mhmmdbdrhmd/can-logger-esp32/CHANGELOG.md

# Changelog

## v2.0.3 — the retry added in v2.0.2 could send the wrong payload

**Use this instead of v2.0.2 if you use the Send tab.** The retry across CAN
passes that v2.0.2 introduced was wrong in two ways, both found in review of
that release and both reproduced on the host:

- **A retried Send rebuilt its frame, and a grouped or multiplexed command
  rebuilt into the wrong bytes.** Several values that share one frame are
  assembled in a holding buffer, and that buffer is consumed when the frame
  goes out. A retry built the frame a second time, found the held values gone,
  and transmitted the selector with a zeroed payload — a valid-looking command
  carrying wrong numbers to whatever acts on it. A retry now carries the frame
  that was already built and sends exactly those bytes.
- **A retried Send was reported as failed even when it went out.** The outcome
  was recorded before the decision to retry, so the dashboard — which keeps the
  first result it sees for a ticket — showed "the bus was too busy to get on"
  for a Send that succeeded a pass later. Nothing is recorded now until the
  result is final. This also stops one retried Send filling the four-deep
  result ring and evicting every other Send's outcome.
- A retry that cannot be put back (the request queue is full) is reported as a
  failure instead of disappearing silently.
- A cyclic repeat is marked "do not retry" with its own flag, so the failure
  line no longer claims a cyclic send was "retried on later passes too".
- `test/test_cantx.cpp` covers all of it, including a real grouped send built
  from `examples/machine.dbc`: with the fix removed, the test reports the held
  value going out as zero.

## v2.0.2 — a failed Send no longer costs frames, and a recovered SD write no longer breaks a row

- **A Send that loses arbitration no longer loses received frames.** On a busy
  bus a Send can lose arbitration on all three attempts. The receive buffers
  were emptied while a send was waiting, but not between attempts and not
  after the last one, and writing the error line took long enough for the
  controller to overflow. On the bench, 220 failed sends cost 69 frames in one
  10-minute recording. The buffers are now emptied after every attempt and
  after the logging that follows a send. The same bench, with 117 failed sends
  in 10 minutes, recorded `lost 0`. `test_mcp2515.cpp` checks the drains.
- **A recovered SD write no longer duplicates bytes.** When a write fails, the
  card may already hold the start of the block. The recovery added in v2.0.1
  wrote the whole block again, and on the bench 29 bytes appeared twice and
  broke one row. The recovery now reads the file's length on the card and
  continues from there. Bytes the card dropped before the block are counted as
  lost. `SD_FAULT_TEST_AT_KB` now lets part of the block reach the card before
  the failure, which is how it happened. `test_sdutil.cpp` covers the
  arithmetic.
- **`lost` comes first on the status line.** The line is cut at
  `LOG_LINE_CHARS`, and with `lost` at the end, `lost 69` was printed as
  `lost 6`. It now follows the time: `REC 1.csv 00:02:21 | lost 0 | ...`.
- **The heap figures in the `health:` line reach the card.** The line had
  outgrown `LOG_LINE_CHARS` and was cut at `minHeap=`, so `block`, `lowBlock`
  and `allocFail` never appeared in a recording. It is now three lines
  (`health:`, `health sd:`, `health heap:`). The first also carries `gap` and
  `tx`, the longest time between two drains and the longest pass spent sending,
  which were measured but never printed.
- **The closing summary reports the smallest free block in bytes,** against the
  2308 bytes an inbound connection needs, with the count of refused
  allocations. "1 KB" hid the difference between a dashboard that answers and
  one that refuses to connect.
- **`/api/log` sends at most 16 lines a reply,** from one buffer taken once.
  With the Log tab open it could build the whole 80-line ring, about 14 KB,
  and copy it into a second String of the same size. The page polls every
  700 ms, so it still gets more than 20 lines a second.
- The host test that checks a handler emits no field twice now sees field
  names with an underscore.
- **A Send that loses arbitration is retried on a later pass of the CAN task**
  (`TX_RETRY_PASSES`, 3), after the receive buffers have been drained and long
  enough for a burst to end. The attempts inside `sendFrame()` are back to
  back, so on a bursty bus they are all spent inside the same burst. Measured
  twice at 5 sends/s into a bursty 350 frames/s bus: 9 and 602 failed sends
  without it, 0 and 0 with it, no frames lost either way. Six attempts back to
  back scored 1 and 1 and were not taken - on a bus that acknowledges nothing,
  six attempts block the receive path for 120 ms.

## v2.0.1 — nothing the layout uses is trimmed, and a failed SD write is recovered

- **Trimming keeps what the dashboard and the Send tab use.** The Web UI sheet
  can now trim both frame maps together when neither alone is enough, and it
  lists each trade-off it found - both maps at the current name length, or one
  map with shorter names - with how many signals each map keeps. A message
  that a dashboard cell or a sendable value names is never dropped, and is
  kept whole. The page saves any layout change still waiting before it trims,
  previews or exports. When the messages the layout uses are too much on their
  own, the sheet says so. `test/test_desk.py` pins the largest messages in a
  layout and checks that nothing it uses is lost.
- **A failed SD write no longer stops the recording in silence.** FatFS keeps
  an error on an open file once a write fails and refuses every later write to
  it. On a bench board, one card error four and a half minutes into a
  recording left the CSV frozen for the rest of it, while the `.log` beside it
  carried on and the status line said `lost 0`. The CSV is now reopened for
  appending and the write retried. Anything that still cannot be written is
  counted: `SD LOST n KB` on the status line, on the page's SD card, in
  `/api/status` as `sdLost`, and in a closing line that calls the file
  incomplete. `SD_FAULT_TEST_AT_KB` injects the failure for a bench test.
- The core no longer prints "does not exist" errors when the firmware removes
  or checks for a file that is not there.

## v2.0.0 — two buses

The logger now records **two CAN buses at once**, on one clock, into one file.
This is a fork of `can-logger-esp32` and keeps its history; everything below is
what changed to get the second bus, and what it cost.

Major version because **the CSV schema changed** — see below. Recordings made by
the single-bus logger are still readable by the desk tools, but a file written
by this one has an extra column.

### One desk tool, one setup file, and a name length chosen per setup

- **`customize.py` is the one desk tool.** It takes one or two frame maps, or an
  exported bundle. The page gains **Preview**, which shows the setup the way the
  logger will load it: names at the chosen length, a map cut down if the logger
  cannot hold it whole, cells that would no longer resolve left out.
- **The Web UI badge predicts from the maps** (`tools/heap_model.py`) whether
  the logger will keep serving the page while it records, for name lengths 64,
  32 and 16, and offers the fixes as buttons: trim `frames.dbc`,
  `frames2.dbc` or both, or a shorter name length. A trim never drops a
  message that a dashboard cell or a sendable value uses, and the page sends
  any layout change still waiting to be saved before it trims.
- **Export writes one file, `logger.bundle`**: both maps, the layout and the
  name length (`tools/make_bundle.py`). Names too long for the length are
  **abbreviated**, not cut (`tools/dbc_abbrev.py`: `EngineCoolantTemperature`
  -> `EngineCoolTemp`), kept distinct, and the layout is rewritten to match.
  The logger unpacks it at start-up, once, and renames it `/logger.applied`;
  **Import** on the logger's own page uploads one and restarts.
- **The name length is chosen at run time.** Names live in one pool sized from
  the bundle's `name_max`, so a setup at 32 or 16 gives its memory back to the
  web server without a rebuild. `DBC_NAME_MAX` is now only the ceiling.
- **The web server got 12 KB back** by default: `FRAME_QUEUE_LEN` 256,
  `LOG_QUEUE_LEN` 16, `TASK_STACK_WRITER` 6144. On a bench board with one small
  map the largest free block at start-up went from 34804 to 47092 bytes, and the
  page from dying within a minute to answering every request. The `.log` file
  reports each task's unused stack.
- **A recording no longer drops frames while it opens its files.** Finding a
  free file name on a well-used card took 1.5 s and filled the queue; the queue
  is now drained in between, and those frames are counted but not recorded.
- **The boot log records the heap at every step of starting a recording**, and
  each frame map's per-entry cost.

### Found on a real bench: the dashboard died in station mode, and a Send cost frames

Running this firmware on a real machine - station mode through a router, a
WROOM board with no PSRAM, and a large vendor frame map - turned up faults that
the hotspot setup had hidden. Before the fixes, with a small map and nothing
else changed, the dashboard stopped answering 25 seconds after boot and never
came back (`write(): fail on fd 50, errno: 11` once a second on the console),
while the recording ran on untouched.

**The web server**

- **The page went out in parts of up to 73 KB per socket write.** lwIP's send
  buffer is a few kilobytes; in station mode the write came back EAGAIN and the
  page died half-sent. It now goes out in 2 KB slices with a real
  Content-Length, pre-compressed (`src/webpage_gz.h`, 3.3x smaller, generated by
  `tools/gen_page_gz.py` and checked by `run_tests.sh`).
- **Nothing stopped a stalled send.** A client that stopped reading held the
  one-client-at-a-time server for up to ten seconds per slice. Every response
  now gives up after `WEB_SEND_MAX_MS`, a single write is bounded with
  `SO_SNDTIMEO`, and an abandoned page is closed with a reset instead of being
  retransmitted for minutes out of the heap new connections need.
- **`/api/status` and `/api/dash` rebuilt their reply with a reallocation per
  append**, five times a second - and then reserved 16 KB in one piece for a
  2 KB reply, which failed once the heap was fragmented. Static buffers, sized
  to what the replies measure.
- **Unknown `/api/` paths and `/favicon.ico` were answered with the whole
  page.** Now a small 404 and a 204.
- **`/api/signals` streamed a large map back to back without yielding**, so
  the reply was truncated and the page never finished starting. It yields
  between chunks now.

**Memory**

- **The heap gauge read the wrong pool.** `ESP.getFreeHeap()` counts 32-bit
  IRAM that `malloc()` can never return, so it reported ~41 KB that did not
  exist. `src/mem.cpp` reads the 8-bit pool, tracks the largest free block and
  its low-water mark, logs a boot ladder into the recording, and traps failed
  allocations - which is how the real mechanism was found: every refused
  allocation was the ~2.3 KB receive buffer an incoming connection needs.
- **`DBC_HEAP_RESERVE` had been tuned against that wrong gauge.** Against the
  real figure it exceeded the whole heap and every message on both buses was
  dropped. It is 40 KB now, and a zero budget is reported as a configuration
  error rather than as a map that did not fit.
- **The radio now starts before the frame maps load.** It needs a few large
  contiguous blocks, and a freshly parsed map had already cut the heap into
  pieces: one vendor map left 80 KB free and Wi-Fi still would not start.
- **`FRAME_QUEUE_LEN` is 512, not 2048** (now 256, see above). The queue comes
  out of the heap; its measured peak on a 350 frames/s bus was 13.
- The boot log now says, at the end of setup, whether the dashboard can be
  expected to stay reachable - see "Keeping the dashboard reachable" in the
  README for the three zones it reports and where they come from.

**Frames**

- **A transmit stopped the receive path.** `sendFrame()` waits up to 20 ms per
  attempt for the controller, in the only task that empties the receive
  buffers; at 350 frames/s that is enough to overflow. The wait now drains both
  controllers between polls. With it, a 10-minute recording at 350 frames/s
  with one Send every second lost no frame; a run without it has not been
  made, so how often the old wait cost frames is not measured.
- **The receive task wrote to the SD card.** The overflow and sticky-flag paths
  called `LOG_FILE` from the task with the microsecond deadline, onto the card
  the CSV was being written to. They are counted now, and reported on the status
  line; nothing in that task touches the card.

**Frame maps**

- **The DBC was read one byte at a time**: one filesystem call per byte, which
  made a megabyte-class map take over a minute and a half at boot. 512-byte
  blocks now.
- **Ceilings raised** to 4096 messages / 16384 signals / 16384 value labels,
  and `DBC_NAME_MAX` to 64 (now the ceiling, see above): a real vendor map lost 310 names at 32, and two
  signals differing only past character 31 became one CSV column.
- **A readable map that did not fit was reported as thousands of unparsable
  lines.** Skipped definitions are counted apart from malformed ones now, and
  the `NS_` keyword list no longer counts as an error in every file.
- **Signals of a dropped message were attached to the previous one.** When the
  message table was full, the `SG_` lines under the message that did not fit
  were appended to the last message that did - which then decoded its frames
  with another message's bits. They are skipped now, and a test fails if they
  are not.
- **A `VAL_` line naming a clipped signal in full never matched**, so its value
  table was lost. Names are compared the way they were stored.
- **The SD card could stay wedged after a USB flash.** A reset mid-write leaves
  the card holding its data line busy; the firmware now clocks it free before
  mounting and retries the whole speed ladder with longer pauses.

**Desk tools and tests**

- **`preview_dashboard.py` merged value tables across messages** that reuse a
  signal name (normal in J1939): wrong labels, and a heap estimate 2.3x the
  firmware's. Keyed by message and signal now; the parser comparison in
  `run_tests.sh` counts value labels and includes a file that exercises it.
- `run_tests.sh` runs from any directory; the page-versus-firmware field check
  accepts underscored names; the host shims answer heap questions with figures
  measured on a board instead of a flat 200 000.

### The schema: eight columns, `bus` second

```
t_us;bus;id;name;signal;value;unit;raw
0;1;0x100;NodeStatus;Uptime;42;s;
1500;2;0x100;PumpState;Pressure;3.5;bar;
```

Those two rows carry **the same identifier on different buses, decoded into
different messages**. That is the normal case on a real machine, and it is the
reason the column exists.

`bus` is second, not appended, because it is part of a row's *identity* rather
than its payload: with two buses an identifier alone no longer names anything.
Group on `(t_us, bus, id)`. Putting it next to `t_us` and `id` is what makes
that hard to forget.

The companion `N.meta` now carries `"schema": 2`, so a tool can branch on a
number instead of counting separators. `tools/parse_log.py` and
`tools/plot_log.py` read both schemas and report a seven-column recording as
`CAN1`.

### Each bus can find its own bit rate

`CAN1_AUTODETECT` / `CAN2_AUTODETECT`, off by default. Set one to `1` and that
bus listens at each `(bit rate, crystal)` pair the driver has timings for and
keeps the first that decodes real frames. The pair already in `config.h` is
tried first, so a correct configuration costs one 300 ms window and usually far
less.

It listens in **listen-only mode whatever `CAN<n>_LISTEN_ONLY` says**. At the
wrong bit rate a normal-mode node reads valid traffic as malformed and answers
with error frames; a tool that corrupts the bus while it works out how to read
it would be worse than no tool.

Two honest limits, both in the log and in the README:

- **It needs traffic.** A quiet bus is indistinguishable from a wrong bit rate.
  Detection then fails and the `config.h` values are used — it never leaves a
  bus unconfigured.
- **A crystal and a bit rate multiply.** The registers for 250 kbit/s on an
  8 MHz module produce 500 kbit/s on a 16 MHz one, and both decode the same wire
  perfectly. Nothing over SPI separates them, so the configured crystal is swept
  first and a fallback to the other one is warned about: the bus is readable
  either way, but the reported *rate* is scaled by the same factor.

The Bus tab says which it was — `250 kbit/s detected` versus
`250 kbit/s assumed` — because a rate the machine confirmed and a rate somebody
typed are worth different amounts of trust. `MCP_RATES` / `MCP_CRYSTALS` are
exported from the driver and asserted against its own timing table in
`test/test_mcp2515.cpp`, so a candidate the search tries can never be one the
driver would quietly refuse.

### One frame map per bus

`/frames.dbc` for CAN1, `/frames2.dbc` for CAN2. Separate files, because the
same identifier routinely means different things on two buses — a shared map
would decode CAN2 with CAN1's meanings and be confidently, silently wrong. Two
buses that genuinely share an ID space can be given identical files.

Either may be absent; that bus records raw bytes, exactly as a logger with no
map at all does. They are fitted to the heap in order, CAN1 first, so a very
large map on CAN1 is the one that shrinks CAN2's — and the log says so when it
happens.

### One task drives both controllers

Both MCP2515s share VSPI; only CS and INT are unique. The obvious design — a
reader task each — is the wrong one: two tasks would contend for the SPI bus
mutex on the one path that has a hard deadline, adding a priority-inversion
surface in exchange for nothing, since the work is identical either way.

So there is still one reader task at priority 20. It drains controller 1, then
controller 2, on every pass. Two ISRs, one per INT line, each pushing into its
own timestamp ring and notifying that same task.

Both rings are fed from the same `esp_timer`, which is the point: a frame on
CAN1 and a frame on CAN2 are directly comparable to the microsecond. Two
recorders with two clocks cannot do that, and it is the whole reason to log two
buses on one device.

### One block SPI transfer per transaction, instead of one per byte

This is the change the second bus actually turned on, and it would have been
invisible with one.

A controller holds two frames; at 500 kbit/s a third arrives about **200 µs**
after the first. `readFrame()` already used the right instructions — `READ
STATUS` then the burst `READ RX BUFFER`, 16 bytes, ~13 µs of clock at 10 MHz —
but it clocked them with one `SPIClass::transfer(uint8_t)` per byte, and on
arduino-esp32 each of those is a complete peripheral round trip costing 2–3 µs.

| | per frame | drain 2 controllers × 2 frames | vs 200 µs |
|---|---|---|---|
| per-byte | ~45 µs | ~245 µs | **misses** |
| block | ~18 µs | ~115 µs | ~40 % margin |

Every register access and both frame paths now go through `MCP2515::xfer`, one
`transferBytes()` per transaction. `MCP2515::readRegs()` was dead code and is
gone.

### The margin is measured

`drainMaxUs` — the worst microseconds one pass spent emptying **both**
controllers — is on the dashboard, in `/api/status` and in the `health:` line.
Under 120 µs is comfortable; approaching 200 µs means the margin is gone. A
figure you can read beats a design note you have to trust.

### `CanFrame` gained a bus and did not grow

The struct was exactly 24 bytes with no padding left, so a plain `uint8_t bus`
would have aligned it to 32 — a third more RAM for a queue thousands of entries
deep. Packing the flags as bitfields (`ext:1, rtr:1, tx:1, bus:1`) got it for
free and changed no call site, since those only ever held 0 or 1. A
`static_assert` now makes adding a field a compile error rather than a silent
30 % increase.

### Sizing, for the doubled frame rate

| | was | now | why |
|---|---|---|---|
| `FRAME_QUEUE_LEN` | 1024 | **2048** | Its old comment claimed "one second of slack". At ~6 250 frames/s those entries are 164 ms — less than the ~320 ms outliers SD cards produce. 2048 is ~330 ms, just past the worst stall. |
| `SD_BLOCK_BYTES` | 8192 | **32768** | SD cards are far more efficient with large writes, and two busy buses can ask for several hundred KB/s. |

Static RAM went from 24.9 % to 33.2 %. Nearly all of that is the queue.

### Per-bus health, everywhere

`RecStatus` split into `BusHealth` (frames, interrupts, overflows, load, frame
map, listen-only) and the shared remainder (one queue, one card, one writer).
Split rather than suffixed, because the interesting failure is asymmetric — one
bus deaf while the other is fine — and a routine that averaged the two would be
incapable of saying so.

The status line, the `health:` lines, `/api/status` and the dashboard all report
per bus. The *Data Integrity* card keeps the floor-vs-exact distinction and now
breaks the floor down by bus.

### The web app is dual-aware throughout

- **Health strip**: one card per controller — frame rate, interrupt rate, load,
  INT level — plus a *Capture Path* card showing `drainMaxUs` against its
  deadline. SD and Data Integrity stay shared, so which numbers are per bus is
  obvious at a glance.
- **Bus tab**: a controller selector; live signals and the identifier table show
  one bus at a time. Both buses' values keep feeding the dashboard regardless of
  which is on screen.
- **Dashboard**: a cell remembers its bus, is badged when it is not CAN 1, and
  resolves against that bus's map. The cell editor has a bus picker above the
  signal list — changing it clears the signal, because a reference from the
  other map would produce a cell that looks configured and never updates.
- **Frame map upload**: two header buttons, `Frame map: CAN 1` and
  `Frame map: CAN 2`, so the target is readable *before* the click rather than
  explained in the toast afterwards — and reachable without first working out
  which bus some other tab happens to be showing.
- **Send**: setpoints carry a bus, frames are grouped by bus as well as message,
  and the one-off frame box has its own selector.

`dash.cfg` gained `bus=` on `cell` and `send` lines. It is written only when it
is not bus 1, so every existing layout round trips to exactly the file it came
from.

### One role per bus, and a header column for each

`Role` said which `BU_` node of the frame map this logger IS — the fact that
separates a reading from a command, and the thing both **Fill** buttons split
on. There was one of them, for two buses. It could not be read: the button said
`Role: Tester` without saying which bus that was about, and its sheet listed
whichever map the cell editor happened to be pointed at.

Now one per bus. The header carries a **column per controller** — that bus's
frame map above, that bus's role below — because both are facts about one bus
and nothing else, and a column with the bus named over it says so in less width
than four buttons each spelling it out:

```
        CAN 1          CAN 2
     [Frame map]    [Frame map]
     [Role: Host]   [Role: none]
```

Two buses have separate frame maps and therefore separate `BU_` node lists, so a
name identifying this logger on one usually does not appear in the other's file.
More importantly the logger is routinely **a node on one bus and a listener on
the other** — driving a diagnostic bus while only watching the powertrain — and
one shared answer forced those two situations to give the same reply.

`dash.cfg` gains a `bus=` token on `role`, with bus 1 implicit, so every
`role "Tester"` line ever written still means exactly what it meant:

```
role "Tester"
role "Logger" bus=2
```

`dashDropUnresolved()` now holds each role to **that bus's** node list. It used
to accept a name either map knew, on the reasoning that a tester is still a
tester when the other bus has never heard of it — with a role per bus that
reasoning inverts: a name CAN1's file knows nothing about cannot be the node
this logger is on CAN1, and keeping it leaves CAN1's Fill split on a node absent
from CAN1.

Two things this turned up while it was being tested:

- **`Fill from bus` had silently stopped ordering by anything.** It read the
  live-signal list from a top-level `sig` in `/api/status` — which moved inside
  `can[]` when the second bus arrived. The lookup found nothing, so the button
  that exists to put the signals *actually arriving* first was placing them in
  plain file order and capping nothing. It reads its own bus's element now.
- **The `.meta` sidecar stated the bit rate from `config.h`.** With
  `CANn_AUTODETECT` that is not the rate the controller used, so a recording
  could be labelled with a rate its bus never ran at. `metaJson()` is now given
  what each controller ended up doing, and every entry carries
  `"bitrate_from": "detected" | "config"`, `"crystal_mhz"` and `"present"` — a
  reader with only the file can tell a measured rate from an assumed one.

### The desk tool holds a frame map per bus too

`customize.py` / `tools/preview_dashboard.py` used to hold **one**, which made a
CAN 2 upload from the page a quiet lie: it replaced CAN 1's map and then reported
CAN 2 as unmapped. So a CAN 2 cell could not be laid out at a desk at all — the
one thing this tool exists for.

Now there is one map per bus, `--dbc2` names CAN 2's on the command line, and
`/api/signals?bus=`, the live-signal lists and the identifier tables all answer
out of the bus's own map. A cell is held to the map of the bus **it** names, not
to either map that happens to be loaded: a CAN 2 cell is not rescued by CAN 1's
map containing a signal of that name. `test/run_tests.sh` now runs the
firmware's `dashDropUnresolved()` and the tool's `prune_cfg()` against a layout
that reads from both buses with a *different* map on each, and requires them to
drop exactly the same items — which is the assertion this bug slipped past.

### The hotspot and hostname are unchanged

Still `CAN-Logger` and `can-logger.local`. This firmware is meant to be flashed
onto the single-bus logger's hardware and compared against it, and a saved
Wi-Fi network or a bookmark that breaks on upgrade is friction for no gain.
Both are overridable in `/config.txt`.

### Wiring

CAN1 on **D22/D21** — neither a strapping pin, and unlike GPIO16/17 neither is
taken by PSRAM on a WROVER. CAN2 keeps the single-bus logger's **D5/D17**, so
existing hardware needs one module added rather than rewiring.

`docs/make_wiring.py` regenerates the diagram: shared nets are drawn as one run
with a junction dot, which is what the breadboard looks like. It keeps the note
that most DevKit v1 boards have **no pin marked D17** — the pin silkscreened
TX2 is GPIO17.

### One module fitted is a supported build

Wire one MCP2515 and change nothing: a controller that does not answer at boot
is reported once and then skipped — not read, not interrupt-armed, and shown on
the dashboard as `NOT DETECTED` rather than as a fault.

That guard is load-bearing rather than cosmetic. With no module on a chip
select, MISO is left floating, and a float reading back as `0xFF` looks exactly
like `READ STATUS` reporting a full receive buffer — `readFrame()` would then
never return false and the drain loop would spin until the watchdog fired. The
single-bus logger had the same unguarded loop and never met the problem,
because it never had a second chip select to point at nothing.

`CAN2_ENABLED 0` still exists and now means something narrower: do not even
probe. It is the difference between "there is no second bus" and "there is
supposed to be one" — and the dashboard says `OFF` for the first and
`NOT DETECTED` for the second, because sending somebody to `config.h` when
their module is unplugged is sending them to the wrong file.

The CSV keeps its bus column either way, always saying `1`. A column that
appeared and disappeared depending on how the hardware happened to be populated
would be worse than one that is sometimes constant.

### Removed

- `MCP2515::readRegs()` — dead code, superseded by the block transfer path.
- `csvHeaderBlock()` — dead since the `.meta` sidecar replaced it, and a second
  place the column list was written down. Its test went with it.

### Known limit, stated plainly

Doubling the frame rate moved the binding constraint off the capture path and
onto the **writer**. The CSV is one row per signal, so two fully-mapped busy
500 kbit/s buses can produce ~1.1 MB/s — beyond what an SPI SD card sustains.
The capture path closes with margin; the write path may not. It is instrumented
(`qDrop` is exact) and documented in README §8 rather than hidden.

---

## v1.2.0

### The unit is the frame

The rule that survived every rewrite of this section: **a frame is one message,
and - when the message is multiplexed - one selector code.** Its values are
added, removed and sent together, under one button.

That is not a policy, it is what a CAN frame is. Eight bytes leave the logger
whether or not somebody typed all of them, so the page no longer pretends one
signal of a frame can be sent by itself.

The correction from the last release is that a multiplexed message holds
*several* frames, and they are separate things. `ABS_Cmd` with six opcodes is
now six boxes and six buttons, not one box and one press that emitted six
frames. And `Diagnostics`, whose `Page 0` carries `SupplyVoltage` **and**
`BoardTemp`, is two boxes of two: you cannot have one of those without the
other, because one frame carries both fields and sending one alone asserts a
value for the other that nobody chose.

### Multiplexing you can declare yourself

For a `.dbc` that multiplexes in fact and does not admit it - payloads on the
same bits, an opcode in front of them, no marker anywhere - the setup sheet now
offers a picker on the message: **which signal selects**. Choosing it drops the
selector out of the value list (it is written for you from then on) and gives
every remaining value a **selector code** field.

Both halves are required. The previous release inferred multiplexing from "more
than one signal is set up", which was a guess dressed up as a rule: it grouped
the signals but could not say what code each belonged to, so the frame went out
under opcode 0 whatever the payload. Knowing that `Cmd_Op` selects does not say
that `Cmd_Amp` means opcode 16, and nothing in the file can be read to find out.

Stored as `msel=` and `mxc=` on the `send` lines. An override is dropped rather
than half-obeyed when a later frame map has no signal of that name in the
message, or declares its own `M` - the file wins.

`group=` and `mux=1` are gone from what is written; both are still read from an
older file and ignored.

### A plain signal in a multiplexed message is refused, and says so

A signal with no `m<code>` in a multiplexed message rides in *every* frame that
message sends, so it belongs to no one selector code and this build has nowhere
to put it. It is now left out of the sendable list and named, in the page and in
`tools/check_dbc.py`, instead of quietly going out as zero under a code it does
not belong to. Decoding is unaffected. Recorded in **Known issues** with what it
costs and when it will bite - a counter or CRC the ECU checks.

None of the 15 `.dbc` files this was developed against has one; the shape is
normal in OEM and AUTOSAR-derived files.

### Whole frames only

Half a frame set up is a frame that still goes out, with the signals nobody
configured as zeros. So choosing one signal by hand brings its whole frame with
it, a frame that will not fit in the remaining room is not added at all rather
than added in part, and a setup file written before this rule - or carried
across to a map where the message has gained a signal - is completed on load and
told to you.

### Dashboard and Send tab, visually

- **Every dashboard row is the same height**, the height of the tallest widget
  in the grid, instead of each row shrinking to its own contents. Done with
  `grid-auto-rows:1fr` rather than a fixed number, so nothing here has to be
  kept in step with the widgets.
- **A plain number cell centres its number.** The empty widget area above it was
  pushing the value onto the floor of the cell; it now sits where a gauge's
  needle would be.
- **A number you can send has a `-` and a `+` beside it** instead of the
  browser's own spinner, whose arrows are a few pixels tall and are missing
  altogether on a phone. Stepping is by the value's own step, rounded so ten
  presses of 0.1 read 1 and not 0.9999999999999999. The buttons write nothing to
  the bus, so they stay live when the logger is not armed.

### The desk tools write no files; the logger still saves by itself

`customize.py` and `tools/preview_dashboard.py` **no longer write anything at
all.** They no longer pair a `.cfg` with every `.dbc` they are shown, so loading
a frame map leaves nothing beside it and the page does not come up on a setup
you did not ask for. `--cfg` is read once at the start and never written back;
`--cfg-dir` is gone; **Export** in the page is the one way a setup comes out.

Saving on the logger is unchanged: an edit reaches it about a second after you
stop making it. A **Save to device** button was tried and removed in the same
breath, because it broke the dashboard - `handleDash()` renders the values from
the layout the LOGGER holds, so a cell it has not been told about shows nothing,
and an editing session that had not reached it was one with half the screen
blank. The button is gone; the note in `webpage.cpp` says why, so it does not
get reinvented.

### What you type stays typed

The Send tab redraws whenever anything changes - arming, a poll, a frame
arriving - and every redraw used to put the inputs back to their configured
defaults, throwing away what had been typed. Each box now keeps its values
across redraws and after sending, with a **Reset** to put them back. Kept in the
page only; reloading clears it and nothing reaches the logger.

## v1.1.1

Seven bugs in v1.1.0. The worst of them silently deleted work.

### Multiplexed, or not - the three kinds are down to two

`single`, `grouped` and `multiplexed` were three names for one question, and the
answer was in the frame all along. A sendable frame is now either multiplexed or
it is not, and it is multiplexed when the `.dbc` says so **or** when more than
one of its signals has been set up.

Everything set up against one message is that message's frame, so its signals
are added, removed and sent **together, under one button**. There is no
`group=` on the `send` lines any more (one on an older file is ignored), no
"sent together with" dropdown, and no manual grouped/multiplexed picker: nothing
is left to decide, because a frame is a frame.

The half of the rule that does not come from the file is what makes a `.dbc`
which is multiplexed *in fact* and does not say so - overlapping signals, no
`M`/`m` marker, common on bench command frames - work without a guess or a
switch.

One press still means one frame per **selector code**: payloads under different
codes are alternatives, so a frame multiplexed into six opcodes goes out as six
frames from one press, while a message with one code, or none, is one frame.

### A multiplexed command could be sent half a frame at a time

The editor drew a multiplexed message as one indivisible box — no Remove except
the group's — while the Send tab gave every one of its payloads a Send button of
its own. Both could not be right, and the Send tab was the wrong one: two
payloads under the same selector code are one frame, and sending one of them
alone writes **zero** over the other, because a multiplexed frame cannot be
seeded from what the bus last carried (those bytes belonged to another code and
mean something else).

The rule now, in both tabs and from one function, is that a frame is one message
and — if the message is multiplexed — one CODE of it:

- **single** — one value, alone in its frame. Two payloads under *different*
  codes are two singles, not two halves of one command: they are alternatives
  and can never share a frame.
- **grouped** — several signals of a plain message, chosen to go out together.
  The choice is real and can be undone; the individual Remove stays.
- **multiplexed** — the payloads that share one code. No choice, no individual
  Remove, one **Send all N**.

*Fill from the frame map* now makes a group per selector code rather than
leaving multiplexed payloads ungrouped, and the "sent together with" list no
longer offers to put two codes in one frame — a frame that could never have gone
out as asked. A setup file written before this can still contain one, so
`cantx.cpp` refuses it as well rather than transmitting a single frame with the
last member's opcode written over both payloads.

**The kind can be corrected by hand.** The box header carries a **grouped /
multiplexed** picker, because a `.dbc` that is multiplexed in fact and does not
say so is common and no tool can infer it. The file's answer is the default;
the choice is kept in the setup file and holds with no frame map loaded.

`tools/check_dbc.py` also warns when a message the file does **not** mark as
multiplexed has signals sharing bits — the shape of a frame that is multiplexed
in fact and does not say so. Nothing can infer that (guessing would refuse
legitimate frames), so it is reported rather than assumed.

### Remove deleted every value of a message except the one you pressed

`renderTxEdit()` declared `var mates` twice in one function scope — once for the
values that are **removed together** (a multiplexed set, *including* this card)
and, two hundred lines later, once for the values that are **sent together** in
one frame (*excluding* it). `var` is function-scoped, so the second declaration
reached back and overwrote the first for the Remove button, which had already
closed over it. The button's label was computed before the overwrite, so it went
on reading *"Remove all 4"* while doing something else entirely.

The result, on any message with more than one value set up:

- **Remove** on a plain value deleted the message's *other* values and kept the
  one you asked it to delete. Four sendable values, one press, three gone.
- **Remove all N** on a multiplexed payload left that payload behind — the
  half-described command the grouping exists to prevent.

Legal JavaScript, no syntax error, no warning. `test/run_tests.sh` now walks
every function in the page — including anonymous callbacks, which is where this
one lived — and fails on a `var` declared twice in one scope. Verified by
putting the bug back and watching the check catch it.

### Multiplexed values stopped being a set when the frame map was away

Whether a value belonged to a multiplexed message was looked up in the frame
map. With no map loaded — the desk tool before a `.dbc` is chosen, which is now
its normal starting state — the answer came back "not multiplexed", the set
dissolved, and the payloads became deletable one at a time.

The fact now travels with the value as `mux=1` in the setup file rather than
being re-derived, so the grouping holds with no map at all. Values written by an
earlier version carry no flag and regain their grouping the next time they are
filled from a map.

### Loading a frame map left the old setup behind

A new `.dbc` replaced the map but not the dashboard or the sendable values
built against the old one. Every cell then read as an unknown, the stale
references were **saved back over the setup file**, and the next run loaded
them again — so the mess persisted across restarts and looked like the tool had
forgotten which frame map it was on.

Loading a map now removes every cell and every sendable value the new map
cannot account for, closes the gaps, and saves — on the logger and in the page,
so the card and the screen agree. An unrelated file leaves an empty setup; a
corrected version of the same file leaves the layout intact, because its
signals are still there. One-off frames named by identifier are never touched.

This is deliberately **not** what happens at boot, where an unresolvable cell is
still kept and drawn as such: there the usual cause is a card with no DBC on it,
and throwing away a layout over that would be far worse.

### ...and the desk tool handed it straight back the next morning

The fix above was the logger's half. `customize.py` still opened on **one shared
setup file**, written by whatever map was loaded last — so running it with no
argument re-seeded a setup built for another bus, against no frame map at all, and the page came up on a screen of `unknown` cells with a role naming a
node that was nowhere in sight. Exactly the symptom the fix above was meant to
end, arriving by a different door.

Three things were wrong, and all three are fixed:

- **One setup per frame map, always.** The `.cfg` is named after the `.dbc`. With
  no map named on the command line the page starts *empty*, and loading one from
  the page opens that map's own setup — beside the `.dbc` when there is one,
  beside `customize.py` when the map came from the file picker. Loading a second
  map in the same session switches to its file and leaves the first exactly as
  it was, instead of writing the new bus over the old bus's setup.
- **The preview server never pruned its own copy.** Only the browser did, and
  only the browser's save put the result on disk. It now applies the same rule
  as `dashDropUnresolved()` in the firmware, and `test/run_tests.sh` asserts the
  two implementations agree — same survivors, same order, same answer about the
  role — because one rule with two implementations is how this came back in the
  first place.
- **A role outlived the map that named it.** `role "Tester"` against a file with
  no `Tester` node is not stale but unanswerable: nothing transmits under that
  name, so both Fill buttons stop separating anything while the header goes on
  claiming a role. It is now cleared with everything else the new map cannot
  account for, and the question is asked again.

The page also **re-reads** the setup after a map is loaded rather than pruning a
second copy of it in the browser. Two copies pruning themselves independently is
how a browser holding the old layout gets to write it back over a card that had
just been cleaned.

### Values from a swapped-out map could be deleted one at a time

A third route to the same broken set: a value whose message is no longer in the
loaded map is not recognised as multiplexed either. The clearing above removes
those values outright, so the case no longer arises.

### The editor now boxes a message's values together, like the Send tab

Four cards in a row with four Remove buttons invites you to treat them as four
independent things. On the wire they are one frame, and the Send tab has always
drawn them that way. The editor now does too: one box per message, the message
name and what the grouping means in its header, and a **Remove all N** on the
header.

Inside the box the rule follows what the frame actually allows:

- **Multiplexed payloads** have *no* individual Remove. The group's button is the
  only one, because keeping some payloads of a multiplexed command describes only
  part of it.
- **A plain message whose signals go out together** keeps a Remove on each value
  as well, because wanting three of its four signals is a legitimate thing to
  want.

Worth knowing when reading your own file: a message is only multiplexed if the
`.dbc` says so with `M` and `m0`/`m1` markers. `MachineConfig` in the example and
`ABS_Cmd` in a typical tester file have overlapping signals but no markers, so
they are plain groups — they are sent whole, and their values may be removed one
at a time.

### `customize.py` asked which .dbc to use

It should never have. With no argument it now opens the page with no frame map
and lets the **Frame map** button load one — the same button the logger has.
A path still works as an argument, `--browse` still opens the file dialog, and
the interactive chooser is deleted rather than merely bypassed.

## v1.1.0

### Load a frame map from the web app

**Frame map**, in the header, takes a `.dbc` off the phone or laptop you are
holding and writes it to the card as `/frames.dbc`. The map is rebuilt on the
spot and the dashboard re-binds to it, reporting how many saved cells no longer
match. No card reader, no laptop, no reboot.

It is streamed to the card a chunk at a time rather than buffered: a real
machine's `.dbc` is ninety kilobytes, larger than the map built from it and a
third of the chip's free heap. It lands on a temporary name and is renamed into
place only once the whole file has arrived, so a dropped connection costs the
upload rather than the map already in use.

Refused while a recording is running, and it says why: every CSV opens with a
header naming the exact map its rows were decoded through, so swapping the map
mid-file would make that header wrong for every row after the swap.

### "Which node is this logger?", asked first this time

A `.dbc` names who transmits each message but never which of those nodes is the
box running this firmware — and that is the whole difference between a reading
and a command. The question is back, with three things fixed:

- **It is asked first.** The sheet opens by itself the moment a frame map is
  loaded, which is when it costs nothing to answer. Previously it lived inside
  the setup-file sheet, which is the last thing anyone opens, so by then the
  work it would have saved had been done by hand.
- **Skip is a first-class answer**, and the default. Both Fill buttons then
  offer every message and nothing is separated. On a machine that already works
  none of the nodes in the file is you, which makes skipping the common case,
  not a refusal to answer.
- **The answer is visible.** A **Role** button in the header shows it on every
  tab and changes it any time. A wrong role does not announce itself; it just
  fills the wrong half of the map into the wrong screen.

`customize.py --role <Node>` answers it before the page opens, and leaving the
argument out is the skip. Stored as `role "<Name>"` in `/dash.cfg`; a file
written when the setting was called `node` still keeps its answer.

### Renamed: customise → customize

`customize.py`, `customize.bat`, and every occurrence in the docs and the page.
One spelling, and it is the one the rest of the project already used.

### Also

- The Send tab's Fill button now describes what it will actually do — *"Add
  every signal Host sends"* with a role set, *"in every message"* without one,
  *"in this message"* when one is chosen — instead of always claiming "this
  message".

## v1.0.0

First tagged release.

**Flashing it:** one file at offset `0x0`, the same on macOS, Linux and Windows.

```bash
pip install esptool
python3 tools/flash.py --image can-logger-esp32-v1.1.1-4mb-merged.bin
```

### What it is

An ESP32 + MCP2515 CAN logger that writes every frame to an SD card as CSV,
decodes it live against a DBC file on the card, and serves a web app over its
own Wi-Fi hotspot. Nothing about any particular bus is compiled in.

- **Recording.** Identifiers, timestamps and payloads to `N.csv`, decoded
  through `/frames.dbc` when one is present and as raw bytes when it is not.
  Values are computed in integer arithmetic wherever the factor and offset are
  decimal, so the CSV is bit-exact with respect to the wire.
- **A dashboard you lay out yourself.** A grid up to 6 × 8, ten ways to draw a
  value, drag to rearrange, thresholds per cell. Filled from the frame map in
  one press. Every widget is SVG built in the browser; the ESP32 renders
  nothing.
- **Writing back to the bus.** Values set up at a desk and sent in the field,
  behind an arm gate that expires. Multiplexed commands carry their own
  selector; signals that are only meaningful together leave in one frame.
- **Set up before you go out.** `customize.py` opens the real page against your
  own `.dbc` with simulated data, on any of the three platforms, and writes
  what you build next to it.
- **Diagnostics that are about the receive path**, not just the SD card: the
  interrupt line, sticky controller flags, queue depth, bus load, and frame
  loss reported as the floor it is.

### Known limits

- **The receive path is field-proven; the rest of this build is not.** The
  reader task, the driver and the controller configuration are unchanged from a
  firmware that recorded hours of a ~540 frame/s bus with zero frames lost on
  real hardware. Transmitting, the dashboard and the heap-sized frame map have
  not been on a live wire. Bench those against a node you can afford to
  confuse.
- 32 sendable values is a hard ceiling: whether a value repeats is a bit in a
  32-bit mask, in the firmware and in the browser alike.
- The frame map is sized to your file but bounded by `DBC_HEAP_RESERVE`, which
  keeps memory back for Wi-Fi. A very large map is trimmed and says so.
- Classical CAN only. The MCP2515 has no CAN FD.

### Fixed in this release, found in ~10 h of field recordings

The rates and counts below were measured off those recordings with tooling that
is not part of this repository, so they are **not reproducible from a clone** —
they are why these changes exist, not claims this repo can re-check. Everything
under *Verified* is.

- **The receive interrupt could latch and stay latched.** `ERRIF`/`MERRF` are
  sticky and the INT pin is level-active, so one uncleared flag killed every
  future edge and dropped the receiver to a 20 ms poll — about 135 frames/s
  where the bus was carrying 540. Four of ten recordings were affected, three of
  them from the first byte because the state survived from whatever ran before.
  Error flags are now cleared on every service pass, in an order that cannot
  re-set them, and the pass runs on a timeout rather than only on an interrupt
  so a fix on the interrupt path cannot be dead code exactly when it is needed.
- **The per-identifier log line printed uninitialised memory** when no traffic
  had arrived, truncated its own totals away on any bus with more than about
  nine identifiers, and cut its last entry mid-number by adding `snprintf`'s
  return value blind. It now reports totals first and rotates its window, so a
  hundred-identifier bus is fully described over a minute of lines.
- **Frame loss was understated by about 40 %.** The counter was incremented
  once per service pass that found an overflow, and reported as a frame count;
  in the latched state that made it converge on a poll rate. Overflow *events*
  and a *lower bound* on frames are now separate, and the page says `≥`.
- **The frame map dropped everything past 256 signals.** A 104-message,
  707-signal bus decoded 256 and logged the other 451 as raw payload. The
  tables are counted from the file and allocated to fit it.
- **Signal names were cut at 23 characters**, so `GuidanceCurvatureCommand`
  became `GuidanceCurvatureComman` — long enough to look right, short enough
  that matching CSV rows back to the source DBC by name returned nothing. The
  limit is 31, anything still too long is counted and reported, and every CSV
  header states the cap.

### Verified

`./test/run_tests.sh` — 311 assertions, natively, against the real sources.
`pio run` — RAM 24.9 %, Flash 54.7 %. The web app is driven headlessly against
a simulator, and every figure in the README is reproducible by a command in it.
