mhmmdbdrhmd/can-logger-esp32/src/webpage.cpp

#include "webpage.h"

/* ==========================================================================
 *  PART 1 - the document head and the whole stylesheet.
 *
 *  Dark by default because this is read in a cab, in a workshop, or outdoors
 *  at night, and a white page at 2 a.m. next to a machine is genuinely worse.
 *  The palette is the one the diagnostics view already used.
 * ======================================================================== */
static const char PAGE_1[] PROGMEM = R"HTML(<!doctype html>
<html lang="en"><head>
<meta charset="utf-8">
<meta name="viewport" content="width=device-width,initial-scale=1,viewport-fit=cover">
<title>Dual CAN Logger</title>
<style>
:root{
  --bg:#0e1116; --panel:#171c24; --line:#252c38; --txt:#e8edf5; --dim:#8b97a8;
  --ok:#22c55e; --warn:#f59e0b; --bad:#ef4444; --acc:#3b82f6;
  --track:#222b38; --sunk:#0d1219;
  --tt:180ms;                 /* needle travel: set from the poll interval */
}
*{box-sizing:border-box}
/* The UA rule for [hidden] is display:none at zero specificity, so any class
   that sets display beats it - which is exactly what .bar{display:flex} did to
   the customize toolbar. Say it once, loudly, rather than remembering to add
   a [hidden] variant to every component. */
[hidden]{display:none !important}
body{margin:0;background:var(--bg);color:var(--txt);
  font:16px/1.45 system-ui,-apple-system,"Segoe UI",Roboto,sans-serif;
  padding:14px;padding-bottom:32px;-webkit-text-size-adjust:100%}
h1{font-size:19px;margin:0;letter-spacing:.2px;white-space:nowrap}
header{display:flex;align-items:center;gap:12px;flex-wrap:wrap;margin-bottom:14px}
#conn{margin-left:auto;font-size:13px;color:var(--dim)}
/* Header controls, on every tab: the frame map, who this logger is, and the
   setup file are none of them a dashboard thing or a sending thing. */
.hbtn{width:auto;margin:0;padding:9px 14px;background:transparent;font-size:13px;
  font-weight:500;border:1px solid var(--line);color:var(--dim)}
.hbtn:hover{border-color:var(--acc);color:var(--txt)}
/* An answered role is worth seeing without reading it, because the wrong one
   quietly fills the wrong half of the frame map into the wrong screen. */
.hbtn.set{border-color:var(--acc);color:var(--txt)}
/* The per-bus pair, two columns of two. The grid is what carries the meaning:
   a button sits under the bus it acts on, so neither has to repeat it in its
   own label. Columns share a width so the pairing survives one label being
   longer than the other. */
.busgrp{display:grid;grid-template-columns:repeat(2,minmax(0,1fr));
  gap:6px 8px;align-items:center}
.bushdr{font-size:10px;letter-spacing:.14em;text-transform:uppercase;
  color:var(--dim);text-align:center;padding-bottom:1px}
.busgrp .hbtn{width:100%;padding:7px 10px;text-align:center}
/* The web-UI badge. Green and red rather than a word alone, so the
   state is readable without reading - it sits in a header that is
   scanned, not studied. */
.hbtn.good{border-color:var(--ok);color:var(--ok)}
.hbtn.bad{border-color:var(--bad);color:var(--bad)}
#rolelist button{width:100%;margin:0 0 8px;text-align:left}
#rolelist button.pri{background:var(--acc);border-color:var(--acc);color:#fff}
.card{background:var(--panel);border:1px solid var(--line);border-radius:14px;padding:16px}
.card h2{font-size:12px;letter-spacing:.14em;text-transform:uppercase;
  color:var(--dim);margin:0 0 10px;font-weight:600}
.grid{display:grid;gap:12px;grid-template-columns:repeat(auto-fit,minmax(240px,1fr))}
.grid5{grid-template-columns:repeat(auto-fit,minmax(215px,1fr))}
.ctl{margin-top:12px;grid-template-columns:repeat(auto-fit,minmax(280px,1fr))}
.sub{font-size:13px;color:var(--dim);margin-top:5px}
.foot{color:var(--dim);font-size:12px;margin-top:12px;text-align:center}
/* A button with no class of its own still has to look like part of this page.
   Without this it fell back to the browser's default chrome - a pale slab -
   which is what "Add an option" and "Send this frame" were. */
button{font:inherit;font-weight:650;border:1px solid var(--line);border-radius:11px;
  padding:14px 22px;background:var(--sunk);color:var(--txt);cursor:pointer;
  width:100%;margin-top:12px;letter-spacing:.02em}
button:hover{border-color:var(--acc)}
button:active{transform:translateY(1px)}
button:disabled{opacity:.4;cursor:not-allowed;transform:none}
.start{background:var(--ok);border-color:var(--ok);color:#fff}
.stop{background:var(--bad);border-color:var(--bad);color:#fff}
.sheetbox > button.pri, .card > button.pri, section button.pri{
  background:var(--acc);border-color:var(--acc);color:#fff}
button.reboot{background:transparent;border:1px solid var(--line);color:var(--dim);
  font-weight:500}
button.reboot:hover{border-color:var(--bad);color:var(--bad)}

/* ---- tabs. Only the visible one is polled, which is most of the reason the
       page costs the logger less than the old single view did. ---- */
.tabs{display:flex;gap:2px;background:var(--sunk);border:1px solid var(--line);
  border-radius:12px;padding:3px}
.tabs button{width:auto;margin:0;padding:8px 14px;background:transparent;
  color:var(--dim);border-radius:9px;font-size:13px}
.tabs button.on{background:var(--panel);color:var(--txt)}
.tabs button .pip{display:inline-block;width:6px;height:6px;border-radius:50%;
  background:var(--bad);margin-left:6px;vertical-align:middle;visibility:hidden}
.tabs button.alert .pip{visibility:visible}

/* ---- the dashboard grid ---------------------------------------------- *
   The column count is the user's, right up to the point where honouring it
   would make every cell unreadable. A four-across layout designed at a desk is
   four illegible slivers on the phone that is actually in the cab, so below
   820px it collapses to two and below 420px to one.                        */
/* grid-auto-rows:1fr rather than a number: with the grid's own height left
   to the content, every 1fr row resolves to the tallest row's content, so a
   row of gauges and a row of numbers come out the same height without any
   figure here having to be kept in step with the widgets. */
.dgrid{display:grid;gap:10px;grid-auto-rows:1fr;
  grid-template-columns:repeat(var(--cols,4),minmax(0,1fr))}
@media(max-width:820px){.dgrid{grid-template-columns:repeat(2,minmax(0,1fr))}}
@media(max-width:420px){.dgrid{grid-template-columns:1fr}}

.cell{background:var(--panel);border:1px solid var(--line);border-radius:14px;
  padding:10px 8px 10px;display:flex;flex-direction:column;align-items:center;
  min-height:158px;position:relative;overflow:hidden;touch-action:manipulation}
.cell .cname{font-size:10.5px;letter-spacing:.12em;text-transform:uppercase;
  color:var(--dim);font-weight:600;text-align:center;width:100%;
  white-space:nowrap;overflow:hidden;text-overflow:ellipsis;padding:0 22px}
.cell .gfx{flex:1;min-height:0;width:100%;display:flex;align-items:center;
  justify-content:center;padding:4px 0}
.cell svg{width:100%;height:100%;max-height:118px;display:block;overflow:visible}
.cell .cval{font-size:23px;font-weight:650;font-variant-numeric:tabular-nums;
  line-height:1.05;letter-spacing:-.01em}
.cell .cval.big{font-size:34px}
.cell .cunit{font-size:11.5px;color:var(--dim);margin-top:2px}
/* A cell with no drawing is only a number, and the empty .gfx above it was
   pushing that number onto the floor of the cell. A matching space below
   puts it in the middle, where the needle of a gauge would be. */
.cell.plain::after{content:'';flex:1;min-height:0}
.cell.stale{opacity:.42}
.cell.stale .cval{color:var(--dim)}
.v-ok{color:var(--txt)} .v-warn{color:var(--warn)} .v-bad{color:var(--bad)}
.cell.miss{border-color:rgba(245,158,11,.55)}
.cell .why{font-size:11px;color:var(--warn);text-align:center;padding:0 6px}

/* a state pill, for signals whose value is a name rather than a number */
.pill{padding:9px 18px;border-radius:11px;font-size:19px;font-weight:650;
  letter-spacing:.02em;background:var(--track);color:var(--txt);text-align:center;
  max-width:100%;overflow:hidden;text-overflow:ellipsis;white-space:nowrap}
.pill.p-ok{background:rgba(34,197,94,.16);color:var(--ok)}
.pill.p-warn{background:rgba(245,158,11,.16);color:var(--warn)}
.pill.p-bad{background:rgba(239,68,68,.16);color:var(--bad)}
.pill.p-acc{background:rgba(59,130,246,.16);color:var(--acc)}

/* ---- customize mode ---- */
.bar{display:flex;flex-wrap:wrap;gap:8px;align-items:center;margin-bottom:12px}
.bar button{width:auto;margin:0;padding:10px 15px;font-size:13.5px;
  background:var(--sunk);border:1px solid var(--line);color:var(--txt)}
.bar button.pri{background:var(--acc);border-color:var(--acc)}
.bar button.warn{color:var(--bad);border-color:rgba(239,68,68,.4)}
.bar .spacer{flex:1}
.step{display:flex;align-items:center;gap:6px;background:var(--sunk);
  border:1px solid var(--line);border-radius:11px;padding:4px 6px}
.step span{font-size:11px;letter-spacing:.1em;text-transform:uppercase;
  color:var(--dim);font-weight:600;padding:0 4px}
.step b{font-variant-numeric:tabular-nums;min-width:16px;text-align:center;
  font-size:14px}
/* The bus badge on a dashboard cell. Small, dim and out of the way: it answers
   "which wire is this" when asked, and does not compete with the value. */
.cell .cbus{position:absolute;top:6px;left:8px;font-size:10px;letter-spacing:.4px;
            color:var(--dim);text-transform:uppercase}

/* Bus selectors. Wider than a stepper button because they carry a word, and
   the selected one is filled so "which bus am I looking at" survives a glance
   from arm's length - which is how this page is usually read. */
/* `.step button` sets a 28px square for the +/- steppers, and it is the more
   specific selector, so these have to say `.step .bussel` to win. Written that
   way rather than moving them out of `.step` because the row spacing and
   alignment are exactly what a stepper row already gives. */
.bussel, .step .bussel{
  width:auto;padding:0 14px;height:28px;border-radius:8px;
  font:inherit;font-size:13px;font-weight:500;line-height:26px;
  white-space:nowrap;cursor:pointer;
  border:1px solid var(--line);background:var(--panel);color:var(--txt)}
.bussel + .bussel, .step .bussel + .bussel{margin-left:6px}
.bussel.on, .step .bussel.on{
  background:var(--acc);border-color:var(--acc);color:#08111f;font-weight:600}
.step button{width:28px;height:28px;padding:0;margin:0;border-radius:8px;
  font-size:16px;line-height:1;background:var(--panel)}

.cell .tools{position:absolute;top:6px;right:6px;display:none;gap:4px;z-index:3}
.edit .cell .tools{display:flex}
.cell .tools button{width:26px;height:26px;padding:0;margin:0;border-radius:8px;
  background:var(--sunk);border:1px solid var(--line);color:var(--dim);
  font-size:13px;font-weight:400;line-height:1}
.cell .tools button:hover{color:var(--txt);border-color:var(--acc)}
.edit .cell{cursor:grab;user-select:none;-webkit-user-select:none}
.edit .cell.slot{touch-action:none}
.cell.empty{border-style:dashed;color:var(--dim);align-items:center;
  justify-content:center;cursor:pointer;font-size:13px;gap:6px}
.cell.empty:hover{border-color:var(--acc);color:var(--txt)}
.cell.lift{opacity:.22}
.cell.over{outline:2px dashed var(--acc);outline-offset:-5px}
#ghost{position:fixed;z-index:60;pointer-events:none;opacity:.92;
  transform:translate(-50%,-50%);box-shadow:0 16px 36px rgba(0,0,0,.55);
  border-color:var(--acc)}
.hint{color:var(--dim);font-size:14px;text-align:center;padding:38px 16px;
  border:1px dashed var(--line);border-radius:14px;line-height:1.7}
.hint b{color:var(--txt);font-weight:650}

/* ---- the cell editor ---- */
.sheet{position:fixed;inset:0;background:rgba(4,7,11,.74);z-index:70;
  display:none;align-items:center;justify-content:center;padding:14px}
.sheet.on{display:flex}
.sheetbox{background:var(--panel);border:1px solid var(--line);border-radius:16px;
  width:min(780px,100%);max-height:94vh;overflow:auto;padding:18px}
.sheetbox h3{margin:0 0 14px;font-size:16px;font-weight:650}
.sheetbox h4{margin:16px 0 8px;font-size:11px;letter-spacing:.13em;
  text-transform:uppercase;color:var(--dim);font-weight:600}
.preview{display:flex;justify-content:center;background:var(--sunk);
  border:1px solid var(--line);border-radius:12px;padding:10px;margin-bottom:4px}
.preview .cell{background:transparent;border:0;min-height:170px;width:220px}
.wpick{display:grid;grid-template-columns:repeat(auto-fill,minmax(76px,1fr));gap:8px}
.wpick button{margin:0;padding:7px 3px 5px;background:var(--sunk);
  border:1px solid var(--line);color:var(--dim);border-radius:10px;font-size:9.5px;
  font-weight:600;letter-spacing:.05em;text-transform:uppercase;width:auto;
  display:flex;flex-direction:column;align-items:center;gap:3px}
.wpick button.on{border-color:var(--acc);color:var(--txt);background:#101826}
.wpick svg{width:100%;height:30px}
.slist{max-height:236px;overflow:auto;border:1px solid var(--line);
  border-radius:11px;background:var(--sunk)}
.slist .row{padding:8px 11px;border-bottom:1px solid #1b212b;cursor:pointer;
  display:flex;gap:10px;align-items:baseline}
.slist .row:last-child{border-bottom:0}
.slist .row:hover{background:#141b26}
.slist .row.on{background:#16233a}
.slist .sn{flex:1;font-size:14px;overflow:hidden;text-overflow:ellipsis;
  white-space:nowrap}
.slist .sm{font-size:11px;color:var(--dim);flex:none}
.slist .sv{font-variant-numeric:tabular-nums;font-size:13px;color:var(--acc);
  flex:none}
.slist .none{padding:14px;color:var(--dim);font-size:13px;text-align:center}
.fields{display:grid;grid-template-columns:repeat(auto-fit,minmax(118px,1fr));
  gap:10px}
label{display:block;font-size:10.5px;letter-spacing:.1em;text-transform:uppercase;
  color:var(--dim);margin-bottom:5px;font-weight:600}
input,select,textarea{width:100%;background:var(--sunk);border:1px solid var(--line);
  color:var(--txt);border-radius:9px;padding:9px 11px;font:inherit;font-size:14px}
input:focus,select:focus,textarea:focus{outline:0;border-color:var(--acc)}
input[type=checkbox]{width:auto;accent-color:var(--acc)}
.chk{display:flex;align-items:center;gap:8px;font-size:13px;color:var(--dim);
  margin-top:8px}
.chk label{margin:0;text-transform:none;letter-spacing:0;font-size:13px;
  color:var(--txt);font-weight:400}
.acts{display:flex;gap:8px;margin-top:18px;flex-wrap:wrap}
.acts button{width:auto;margin:0;flex:1;min-width:110px;background:var(--sunk);
  border:1px solid var(--line)}
.acts button.pri{background:var(--acc);border-color:var(--acc);flex:2}
.acts button.warn{color:var(--bad);border-color:rgba(239,68,68,.4);flex:0 0 auto}

/* ---- send ----
   The arm control is a button and nothing cleverer. It was a toggle switch to
   begin with, which read as a setting rather than as an action, and a
   press-and-hold after that, which was simply annoying. What it has to be is
   unmissable, deliberate, and separate from the Send buttons themselves - and
   a big button that changes the whole card when it is on does that. */
/* Fixed to the viewport rather than sticky in the flow: nothing moves when it
   appears, which matters when it appears while somebody is reaching for a
   Send button. */
.armstick{position:fixed;left:0;right:0;top:0;z-index:60;
  display:flex;align-items:center;gap:10px;padding:10px 16px;
  background:rgba(12,16,22,.94);border-bottom:1px solid var(--line);
  backdrop-filter:blur(8px);
  transform:translateY(-101%);transition:transform .18s ease-out}
.armstick.on{transform:none}
.armstick b{font-size:13px;letter-spacing:.1em}
.armstick .sub{margin:0;font-size:12px}
.armstick button{width:auto;margin:0;padding:9px 16px;font-size:13px}
.armstick.live{border-bottom-color:var(--bad);
  background:linear-gradient(180deg,rgba(239,68,68,.16),rgba(12,16,22,.94))}
.armstick.live b{color:var(--bad)}
.armstick.live button{background:transparent;border:1px solid var(--bad);
  color:var(--bad)}
.armstick .dot{background:var(--dim)}
.armstick.live .dot{background:var(--bad)}
@media(max-width:560px){.armstick .sub{display:none}}

#armcard{transition:border-color .25s,background .25s}
#armcard.on{border-color:var(--bad);background:linear-gradient(
  180deg,rgba(239,68,68,.10),rgba(239,68,68,.02))}
.armhead{display:flex;align-items:center;gap:14px;flex-wrap:wrap}
.armhead .txt{flex:1;min-width:150px}
.armstate{font-size:21px;font-weight:700;letter-spacing:.02em;line-height:1.2}
#armcard.on .armstate{color:var(--bad)}
#armbtn{width:auto;margin:0;padding:15px 30px;background:var(--acc);
  font-size:15px;white-space:nowrap}
#armcard.on #armbtn{background:transparent;border:1px solid var(--bad);
  color:var(--bad)}
.armbar{height:4px;border-radius:2px;background:var(--sunk);margin-top:14px;
  overflow:hidden;display:none}
#armcard.on .armbar{display:block}
.armbar span{display:block;height:100%;background:var(--bad);width:100%;
  transition:width 1s linear}

.sendrow{display:flex;align-items:center;gap:10px;padding:13px 0;
  border-bottom:1px solid #1b212b;flex-wrap:wrap}
.sendrow:last-child{border-bottom:0}

/* A frame that only means anything whole, drawn as one thing. The box is the
   point: it is what tells somebody that pressing Send moves all of these. */
.sendgroup{border:1px solid var(--line);border-radius:12px;padding:4px 14px 14px;
  margin:12px 0;background:var(--sunk)}
.sendgroup .ghead{display:flex;align-items:baseline;gap:10px;flex-wrap:wrap;
  padding:11px 0 4px}
.sendgroup .ghead b{font-size:13px;letter-spacing:.08em;text-transform:uppercase}
.sendgroup .ghead span{font-size:12px;color:var(--dim)}
/* The group's own Remove, in the editor. Compact and pushed to the right, like
   the one on each card - left at full width it reads as the group's main
   action, which on a screen full of values it very much is not. */
.sendgroup .ghead button{width:auto;margin:0 0 0 auto;padding:7px 12px;
  font-size:12px;color:var(--bad);border-color:transparent;background:transparent}
.sendgroup .ghead button:hover{border-color:var(--bad)}
/* Editor groups only: let the explanation take the space it needs so the button
   stays on the first line with the name, instead of being pushed to a third. */
.txgroup .ghead{align-items:center}
.txgroup .ghead span{flex:1 1 240px}
/* A message that holds several frames. The outer box is only a container, so it
   is drawn flatter than the frames inside it - otherwise two nested boxes of
   equal weight read as two separate things to press. */
.msgbox{background:transparent;border-style:dashed}
.msgbox > .sendgroup{margin:8px 0;background:var(--sunk);border-style:solid}
.msgbox > .ghead b{color:var(--acc)}
/* Naming the selector by hand: a control on the message, not on a frame. */
.muxctl{display:flex;align-items:center;gap:8px;margin:0 0 0 auto}
.muxctl select{width:auto;padding:6px 10px;font-size:12px}
.muxctl .sub{font-size:12px;color:var(--dim)}
.muxctl button{width:auto;margin:0;padding:7px 12px;font-size:12px}
/* Send takes the room; Reset only undoes typing, so it sits beside it at the
   width of its own label rather than claiming a row of its own. */
.gacts{display:flex;gap:10px;align-items:stretch;margin-top:12px}
.gacts > button{margin:0}
.gacts > button.pri{flex:1 1 auto}
.gacts > button.quiet{flex:0 0 auto;width:auto;padding:0 18px;font-size:13px;
  color:var(--dim);background:transparent}
.gacts > button.quiet:hover{color:var(--fg);border-color:var(--dim)}
.sendgroup .sendrow{border-bottom:1px dashed #1b212b}
.sendgroup .sendrow:last-of-type{border-bottom:0}
.sendrow .lbl em{font-style:normal;color:var(--acc)}
.sendrow .lbl{flex:1 1 150px;min-width:130px;font-size:14.5px;font-weight:600}
.sendrow .lbl small{display:block;font-weight:400;font-size:11.5px;
  color:var(--dim);font-variant-numeric:tabular-nums}
.sendrow .inp{flex:1 1 210px;display:flex;align-items:center;gap:9px;min-width:0}
.sendrow input[type=number]{width:110px;flex:none;text-align:right;
  font-variant-numeric:tabular-nums}
.sendrow input[type=range]{flex:1;min-width:110px;accent-color:var(--acc);
  padding:0;background:transparent;border:0}
.sendrow select{flex:1;min-width:120px}
.sendrow .u{font-size:12px;color:var(--dim);min-width:30px}
/* The browser's own number spinner is two arrows a few pixels tall, and on a
   phone it is not there at all. This is a value somebody may be nudging while
   standing next to a machine, so it gets buttons that can be hit. */
.stepper{display:flex;align-items:stretch;gap:0;flex:none}
.stepper input[type=number]{width:96px;text-align:center;border-radius:0;
  border-left:0;border-right:0;position:relative;z-index:1}
.stepper input[type=number]::-webkit-outer-spin-button,
.stepper input[type=number]::-webkit-inner-spin-button{-webkit-appearance:none;
  margin:0}
.stepper input[type=number]{-moz-appearance:textfield}
/* Quiet, like the box between them: these change what is in the input, they do
   not send it, and a blue button next to Send would read as a second Send. */
.stepper button, .sendrow .stepper button{width:40px;flex:none;margin:0;
  padding:0;font-size:18px;font-weight:600;line-height:1;color:var(--dim);
  background:var(--sunk);border:1px solid var(--line)}
.stepper button:first-child{border-radius:10px 0 0 10px}
.stepper button:last-child{border-radius:0 10px 10px 0}
.stepper button:hover:not(:disabled){color:var(--txt);border-color:var(--acc);
  z-index:2}
.sendrow .rv{font-variant-numeric:tabular-nums;font-weight:650;min-width:64px;
  text-align:right;font-size:15px}
.sendrow button{width:auto;margin:0;padding:11px 20px;font-size:13.5px;
  background:var(--acc);flex:none}
.sendrow button.cyc{background:var(--sunk);border:1px solid var(--line);
  color:var(--dim);padding:11px 15px}
.sendrow button.cyc.on{background:rgba(239,68,68,.18);border-color:var(--bad);
  color:var(--bad)}

/* two-state input: two buttons, not a switch - the labels stay visible */
.seg{display:flex;gap:3px;background:var(--sunk);border:1px solid var(--line);
  border-radius:10px;padding:3px;flex:1;min-width:130px}
.seg button{flex:1;width:auto;margin:0;padding:9px 10px;background:transparent;
  color:var(--dim);border-radius:7px;font-size:13px}
.seg button.on{background:var(--acc);color:#fff}

/* the option-list editor in the set-up sheet */
.opts{display:flex;flex-direction:column;gap:6px;margin-top:8px}
.optrow{display:flex;gap:6px;align-items:center}
.optrow input:first-child{width:92px;flex:none}
.optrow button{width:34px;flex:none;margin:0;padding:9px 0;background:var(--sunk);
  border:1px solid var(--line);color:var(--dim);font-weight:400}
.txcard{background:var(--sunk);border:1px solid var(--line);border-radius:12px;
  padding:14px;margin-bottom:10px}
.txcard .head{display:flex;align-items:center;gap:10px;margin-bottom:10px}
.txcard .head b{flex:1;font-size:14px}
.txcard .head button{width:auto;margin:0;padding:7px 12px;font-size:12px;
  background:transparent;border:1px solid var(--line);color:var(--bad)}
.sendrow{display:flex;align-items:center;gap:10px;padding:12px 0;
  border-bottom:1px solid #1b212b;flex-wrap:wrap}
.sendrow:last-child{border-bottom:0}
.sendrow .lbl{flex:1;min-width:130px;font-size:14.5px;font-weight:600}
.sendrow .lbl small{display:block;font-weight:400;font-size:11.5px;
  color:var(--dim);font-variant-numeric:tabular-nums}
.sendrow input{width:118px;flex:none;text-align:right;
  font-variant-numeric:tabular-nums}
.sendrow .u{font-size:12px;color:var(--dim);min-width:34px}
.sendrow button{width:auto;margin:0;padding:10px 18px;font-size:13.5px;
  background:var(--acc)}
.sendrow button.cyc{background:var(--sunk);border:1px solid var(--line);
  color:var(--dim)}
.sendrow button.cyc.on{background:rgba(239,68,68,.18);border-color:var(--bad);
  color:var(--bad)}
.warnbox{background:rgba(245,158,11,.09);border:1px solid rgba(245,158,11,.35);
  border-radius:11px;padding:12px 14px;font-size:13px;line-height:1.6;
  color:#f5d9a8;margin-bottom:14px}
.warnbox b{color:var(--warn)}

/* ---- toasts ---- */
#toasts{position:fixed;left:50%;bottom:18px;transform:translateX(-50%);z-index:80;
  display:flex;flex-direction:column;gap:8px;align-items:center;
  pointer-events:none;width:min(460px,92vw)}
.toast{background:var(--panel);border:1px solid var(--line);
  border-left:3px solid var(--acc);border-radius:10px;padding:10px 15px;
  font-size:13px;box-shadow:0 10px 28px rgba(0,0,0,.5);width:100%;
  animation:rise .18s ease}
@keyframes rise{from{opacity:0;transform:translateY(8px)}}
.toast.bad{border-left-color:var(--bad)}
.toast.ok{border-left-color:var(--ok)}
.toast b{display:block;font-size:12px;color:var(--dim);font-weight:600;
  letter-spacing:.08em;text-transform:uppercase;margin-bottom:2px}

/* ---- diagnostics, unchanged from the view this page grew out of ---- */
.meter{height:6px;border-radius:3px;background:var(--sunk);margin-top:12px;
  overflow:hidden}
.meter span{display:block;height:100%;width:0;background:var(--ok);
  transition:width .4s ease,background .4s ease}
.state{display:flex;align-items:center;gap:12px}
.dot{width:18px;height:18px;border-radius:50%;flex:none;background:var(--dim);
  box-shadow:0 0 0 4px rgba(255,255,255,.05)}
.dot.ok{background:var(--ok);box-shadow:0 0 0 4px rgba(34,197,94,.18)}
.dot.warn{background:var(--warn);box-shadow:0 0 0 4px rgba(245,158,11,.18)}
.dot.bad{background:var(--bad);box-shadow:0 0 0 4px rgba(239,68,68,.18)}
.dot.rec{animation:pulse 1.2s ease-in-out infinite}
@keyframes pulse{50%{opacity:.35}}
.big{font-size:23px;font-weight:650;line-height:1.15}
.scroll{overflow-x:auto}
table{width:100%;border-collapse:collapse;font-variant-numeric:tabular-nums}
th{font-size:11px;letter-spacing:.1em;text-transform:uppercase;color:var(--dim);
  text-align:left;font-weight:600;padding:6px 8px;border-bottom:1px solid var(--line)}
th.num,td.num{text-align:right;font-variant-numeric:tabular-nums}
table.sig{table-layout:fixed}
table.sig th.c1,table.sig td.c1{width:30%}
table.sig th.c2,table.sig td.c2{width:30%}
table.sig th.c3,table.sig td.c3{width:22%}
table.sig th.c4,table.sig td.c4{width:18%;padding-left:14px}
td.ell{overflow:hidden;text-overflow:ellipsis;white-space:nowrap}
td{padding:6px 8px;border-bottom:1px solid #1b212b;font-size:14px}
td.mono{font-family:ui-monospace,SFMono-Regular,Menlo,Consolas,monospace}
tr.un td{color:var(--dim)}
#term{background:#080b0f;border:1px solid var(--line);border-radius:12px;
  margin-top:12px;height:290px;overflow:auto;padding:11px 13px;
  font:12.5px/1.55 ui-monospace,SFMono-Regular,Menlo,Consolas,monospace;
  color:#a8b6c8;white-space:pre-wrap;word-break:break-word}
#term div.W{color:var(--warn)} #term div.E{color:var(--bad)}
#term div.I{color:#cfe0f5}
</style></head><body>
)HTML";

/* ==========================================================================
 *  PART 2 - the markup.
 *
 *  Four views behind one set of tabs, arranged around WHEN each is used:
 *
 *    Dashboard  on the machine. Is the logger healthy, what is the bus doing
 *               in the terms this operator chose, and start/stop.
 *    Bus        when something is wrong or the frame map is being worked out:
 *               the raw identifiers and every decoded signal as text.
 *    Send       writing a value back.
 *    Log        what the logger has been saying.
 *
 *  The Dashboard deliberately carries the health tiles and the recording
 *  controls as well as the custom grid, because those three things are what
 *  somebody standing at the machine needs, and making them switch tabs to find
 *  out whether the card is still being written to would be absurd.
 * ======================================================================== */
static const char PAGE_2[] PROGMEM = R"HTML(
<header>
  <h1>Dual CAN Logger</h1>
  <div class="tabs" id="tabs">
    <button data-tab="dash" class="on">Dashboard</button>
    <button data-tab="bus">Bus</button>
    <button data-tab="send">Send</button>
    <button data-tab="log">Log</button>
  </div>
  <!-- One COLUMN per bus, and the two things that are per bus stacked in it:
       which frame map that bus decodes through, and which node of that map
       this logger is. Both replace something belonging to one bus only, so the
       target has to be readable at the moment of the click rather than
       inferred from a tab the reader may not have opened - and a column with
       the bus named above it says that in less width than four buttons each
       spelling it out. The setup file covers both buses and stays outside. -->
  <div class="busgrp">
    <span class="bushdr">CAN 1</span>
    <span class="bushdr">CAN 2</span>
    <button class="hbtn dbcbtn" data-bus="1">Frame map</button>
    <button class="hbtn dbcbtn" data-bus="2">Frame map</button>
    <button class="hbtn rolebtn" data-bus="1">Role: none</button>
    <button class="hbtn rolebtn" data-bus="2">Role: none</button>
  </div>
  <button id="setupbtn" class="hbtn">Setup file</button>
  <!-- Whether this frame map leaves the logger able to SERVE this page while
       it records. It belongs in the header, next to the button that loads the
       map, because it is a consequence of that map and of nothing else the
       reader does - and because it was previously printed only to the terminal
       that launched the tool, where the person laying out a dashboard in a
       browser never saw it. -->
  <button id="webbtn" class="hbtn">Web UI: &mdash;</button>
  <!-- Only the desk tool shows this: it switches the page between the layout
       being designed and what the logger would load from the exported bundle -
       shortened names, a map cut to fit, cells that no longer resolve. -->
  <button id="prevbtn" class="hbtn" hidden>Preview</button>
  <span id="conn">connecting...</span>
</header>

<!-- ==================== DASHBOARD ==================== -->
<section id="v_dash">

  <!-- health first: this is what a logger is judged on -->
  <div class="grid grid5">
    <div class="card"><h2>SD Card</h2>
      <div class="state"><span class="dot" id="d_sd"></span>
        <div><div class="big" id="t_sd">--</div><div class="sub" id="s_sd"></div></div></div>
    </div>
    <!-- One card per controller. Deliberately NOT merged into a single "Bus"
         card: the failure worth catching is asymmetric - one bus deaf while
         the other is fine - and an averaged figure is exactly the thing that
         would hide it. Frame rate, interrupt health and load are all per bus,
         so they live together here. -->
    <div class="card"><h2>CAN 1</h2>
      <div class="state"><span class="dot" id="d_c1"></span>
        <div><div class="big" id="t_c1">--</div><div class="sub" id="s_c1"></div></div></div>
      <div class="meter"><span id="bar_c1"></span></div>
    </div>
    <div class="card"><h2>CAN 2</h2>
      <div class="state"><span class="dot" id="d_c2"></span>
        <div><div class="big" id="t_c2">--</div><div class="sub" id="s_c2"></div></div></div>
      <div class="meter"><span id="bar_c2"></span></div>
    </div>
    <!-- Shared, because there is one queue and one card. Losing a frame here
         costs it whichever controller it arrived on. -->
    <div class="card"><h2>Data Integrity</h2>
      <div class="state"><span class="dot" id="d_lost"></span>
        <div><div class="big" id="t_lost">--</div><div class="sub" id="s_lost"></div></div></div>
    </div>
    <!-- The number the dual-bus design turns on: worst microseconds spent
         draining BOTH controllers in one pass, against the ~200 us a third
         frame takes to arrive at 500 kbit/s. -->
    <div class="card"><h2>Capture Path</h2>
      <div class="state"><span class="dot" id="d_drain"></span>
        <div><div class="big" id="t_drain">--</div><div class="sub" id="s_drain"></div></div></div>
      <div class="meter"><span id="drainbar"></span></div>
    </div>
  </div>

  <!-- then whatever this operator decided matters -->
  <div class="bar" id="viewbar" style="margin-top:16px">
    <button id="customize">Customize dashboard</button>
    <div class="spacer"></div>
    <span class="sub" id="dashnote">&nbsp;</span>
  </div>

  <div class="bar" id="editbar" hidden style="margin-top:16px">
    <div class="step">
      <span>Columns</span>
      <button id="colminus">&minus;</button><b id="colnum">4</b><button id="colplus">+</button>
    </div>
    <div class="step">
      <span>Rows</span>
      <button id="rowminus">&minus;</button><b id="rownum">2</b><button id="rowplus">+</button>
    </div>
    <button id="fillmap">Fill from frame map</button>
    <button id="fillbus">Fill from bus</button>
    <button id="clearcfg" class="warn">Clear all</button>
    <div class="spacer"></div>
    <button id="donedit" class="pri">Done</button>
  </div>

  <div class="dgrid" id="grid"></div>

  <div class="hint" id="emptyhint" hidden>
    No dashboard has been set up on this logger yet.<br>
    Press <b>Customize dashboard</b>, then tap a cell to choose a signal and how
    to draw it &mdash; or press <b>Fill from frame map</b> to lay out everything
    the loaded <code>.dbc</code> describes, which is how this is normally done at
    a desk before going out.<br>
    <span style="font-size:12.5px">What you build here is written to
    <b>/dash.cfg</b> on the SD card, so it is already there the next time this
    logger starts.</span>
  </div>

  <!-- and the two controls that are needed with cold hands -->
  <div class="grid ctl">
    <div class="card"><h2>Recording</h2>
      <div class="state"><span class="dot" id="d_rec"></span>
        <div><div class="big" id="t_rec">--</div><div class="sub" id="s_rec"></div></div></div>
      <button id="btn" class="start">START</button>
    </div>
    <div class="card"><h2>Logger</h2>
      <div class="state"><span class="dot ok"></span>
        <div><div class="big">RUNNING</div><div class="sub" id="s_up">&nbsp;</div></div></div>
      <button class="reboot" id="rebootbtn">RESTART</button>
    </div>
  </div>
</section>

<!-- ==================== BUS ==================== -->
<section id="v_bus" hidden>
  <!-- One bus at a time rather than two tables side by side. The question a
       reader has here is "what is on THIS wire", and interleaving two buses
       into one table answers a question nobody asked while making the real one
       harder. The selector is remembered for the session. -->
  <div class="bar">
    <div class="step" id="buspick">
      <button class="bussel on" data-bus="1">CAN 1</button
      ><button class="bussel" data-bus="2">CAN 2</button>
    </div>
    <div class="spacer"></div>
    <span class="sub" id="s_buspick">&nbsp;</span>
  </div>

  <div class="card" style="margin-top:12px">
    <h2>Live Signals</h2>
    <div class="scroll">
      <table class="sig"><thead><tr>
        <th class="c1">Message</th><th class="c2">Signal</th>
        <th class="c3 num">Value</th><th class="c4">Unit</th>
      </tr></thead><tbody id="sigs"></tbody></table>
    </div>
    <div class="sub" id="s_sigs">&nbsp;</div>
  </div>

  <div class="card" style="margin-top:12px">
    <h2>Identifiers on the wire</h2>
    <div class="scroll">
      <table><thead><tr>
        <th>ID</th><th>Last payload</th><th>Frames</th><th>Rate</th><th>Mapped</th>
      </tr></thead><tbody id="ids"></tbody></table>
    </div>
    <div class="sub" id="s_ids">&nbsp;</div>
  </div>
</section>

<!-- ==================== SEND ==================== -->
<section id="v_send" hidden>
  <!-- The arm control again, pinned to the top of the screen once the real one
       has scrolled away. With thirty values set up, ARM and DISARM must not be
       a scroll to the top of the page. -->
  <div class="armstick" id="armstick">
    <span class="dot" id="stickdot"></span>
    <b id="stickstate">NOT ARMED</b>
    <span class="sub" id="sticksub"></span>
    <div class="spacer"></div>
    <button id="stickbtn">ARM TRANSMIT</button>
  </div>

  <div class="warnbox">
    <b>This writes to the bus.</b> A frame sent to a live controller can move
    hydraulics, release a brake or enable a drive &mdash; the logger sends what
    it is told and cannot know which. Arm it only when you know what is on the
    other end, and what the value you are about to send does.
  </div>

  <div class="card" id="armcard">
    <h2>Permission</h2>
    <div class="armhead">
      <div class="txt">
        <div class="armstate" id="armstate">NOT ARMED</div>
        <div class="sub" id="armsub">Send is disabled</div>
      </div>
      <button id="armbtn">ARM TRANSMIT</button>
    </div>
    <div class="armbar"><span id="armfill"></span></div>
  </div>

  <!-- Where "Customize dashboard" sits on the other tab: above the thing it
       changes, not buried under it. -->
  <div class="bar" style="margin-top:14px">
    <button id="editsend">Set up sendable values</button>
    <div class="spacer"></div>
    <span class="sub" id="sendcount">&nbsp;</span>
  </div>

  <div class="card" id="savedcard" style="margin-top:12px" hidden>
    <h2>Saved values</h2>
    <div id="sendlist"></div>
    <div class="sub" id="sendnote">&nbsp;</div>
  </div>

  <div class="card" style="margin-top:12px">
    <h2>One-off frame</h2>
    <div class="fields">
      <div><label for="rawid">Identifier</label>
        <input id="rawid" placeholder="0x600" autocomplete="off"></div>
      <div style="grid-column:span 2"><label for="rawdata">Payload, hex</label>
        <input id="rawdata" placeholder="2F10200001000000" autocomplete="off"></div>
    </div>
    <div class="step" id="rawbus" style="margin:8px 0"></div>
    <button id="rawsend" class="pri">Send this frame</button>
    <div class="sub">Up to eight bytes, exactly as typed. This is the way out
      when a value is not in the frame map at all &mdash; nothing about it is
      remembered.</div>
  </div>
</section>

<!-- ==================== LOG ==================== -->
<section id="v_log" hidden>
  <div class="card"><h2>Live Log</h2><div id="term"></div></div>
</section>

<div class="foot" id="foot">&nbsp;</div>
<div id="toasts"></div>

<!-- the dashboard cell editor -->
<div class="sheet" id="sheet">
  <div class="sheetbox">
    <h3 id="sheettitle">Cell</h3>
    <div class="preview"><div class="cell" id="prevcell"></div></div>

    <h4>Signal</h4>
    <div class="step" id="ebus" style="margin-bottom:8px"></div>
    <input id="sfilter" placeholder="Search messages and signals" autocomplete="off">
    <div class="slist" id="slist" style="margin-top:8px"></div>

    <h4>How to draw it</h4>
    <div class="wpick" id="wpick"></div>

    <h4>Details</h4>
    <div class="fields">
      <div><label for="f_label">Title</label><input id="f_label" autocomplete="off"></div>
      <div id="fw_unit"><label for="f_unit">Unit</label><input id="f_unit" autocomplete="off"></div>
      <div id="fw_dec"><label for="f_dec">Decimals</label><input id="f_dec" type="number" min="0" max="6"></div>
      <div id="fw_lo"><label for="f_lo">Minimum</label><input id="f_lo" type="number" step="any"></div>
      <div id="fw_hi"><label for="f_hi">Maximum</label><input id="f_hi" type="number" step="any"></div>
    </div>
    <div class="hint" id="statenote" hidden style="margin-top:10px"></div>

    <h4 id="h_thresh">Colour thresholds &mdash; optional</h4>
    <div class="fields" id="fw_thresh">
      <div><label for="f_warn">Amber past</label><input id="f_warn" type="number" step="any" placeholder="none"></div>
      <div><label for="f_crit">Red past</label><input id="f_crit" type="number" step="any" placeholder="none"></div>
    </div>
    <div class="chk" id="fw_lowbad">
      <input type="checkbox" id="f_lowbad"><label for="f_lowbad">Low values are the bad ones (a level or a pressure that must not drop)</label>
    </div>

    <div class="acts">
      <button id="e_del" class="warn">Remove</button>
      <button id="e_cancel">Cancel</button>
      <button id="e_ok" class="pri">Apply</button>
    </div>
  </div>
</div>

<!-- setting up the values that can be sent -->
<div class="sheet" id="txsheet">
  <div class="sheetbox">
    <h3>Values that can be sent</h3>
    <div class="sub" style="margin-bottom:14px">Set these up here, before you go
      out. Choose the signal from the frame map, then decide how the value is
      picked &mdash; a list of the four tyre sizes your fleet actually uses is a
      far better thing to hand somebody standing next to a running machine than
      an empty number box.</div>
    <div class="card" style="margin-bottom:14px">
      <h2>Which bus</h2>
      <div class="sub" style="margin:0 0 8px">Values already set up for the
        other bus stay exactly as they are. This chooses which frame map the
        list below offers, and which controller a value added from here will
        be sent on.</div>
      <div class="step" id="txbus"></div>
    </div>

    <div class="card" style="margin-bottom:14px">
      <h2>Fill from the frame map</h2>
      <div class="sub" style="margin:0 0 4px">Most machines take their settings
        from one message. Choose it, and every signal in it becomes a value you
        can send, with the input guessed from the file &mdash; a signal the
        <code>.dbc</code> gives names to becomes a list, a one-bit signal becomes
        two states, a signal with a declared range becomes a slider, anything
        else a number box. Change any of them below.</div>
      <select id="txfillmsg"></select>
      <button id="txfill">Add every signal in this message</button>
    </div>

    <div id="txeditlist"></div>
    <div class="acts">
      <button id="tx_add">Add a value</button>
      <button id="tx_cancel">Cancel</button>
      <button id="tx_ok" class="pri">Apply</button>
    </div>
  </div>
</div>

<!-- the setup file: one sheet, reachable from every tab -->
<div class="sheet" id="cfgsheet">
  <div class="sheetbox">
    <h3>Setup file</h3>
    <div class="sub" style="margin-bottom:14px">Everything you customize on this
      logger lives in one file, <b>/dash.cfg</b> on the SD card &mdash; the
      dashboard cells <i>and</i> the values that can be sent. There is nothing
      else to back up, and nothing else to copy onto the next machine.</div>

    <div class="card"><h2>What is on this logger now</h2>
      <div class="big" id="cfgsummary">&mdash;</div>
      <div class="sub" id="cfgbytes">&nbsp;</div>
    </div>

    <h4>Export</h4>
    <div class="sub">Downloads <b>logger.bundle</b> to the phone or laptop you
      are holding &mdash; the frame maps and this layout together, because a
      layout without the maps it was built against is a page full of
      &ldquo;unknown&rdquo;. Copy that one file onto another logger&rsquo;s card
      and it unpacks itself at boot. Nothing here changes and no card is
      written, so it is safe to press at any time &mdash; including in the
      middle of a recording.</div>
    <button class="cfgexport pri">Export to this device</button>

    <h4>Import</h4>
    <div class="sub">Replaces <b>both</b> halves &mdash; the dashboard and the
      sendable values &mdash; on the SD card and in the logger&rsquo;s own
      memory. Export first if you want the current one back.</div>
    <button class="cfgimport">Import from this device</button>

    <div class="acts">
      <button id="cfg_close" class="pri">Close</button>
    </div>
  </div>
</div>

<!-- which node of the frame map this logger is, asked FIRST because it is
     what both Fill buttons need in order to be useful -->
<div class="sheet" id="rolesheet">
  <div class="sheetbox">
    <h3 id="roletitle">Which of these is this logger?</h3>
    <div class="sub" style="margin-bottom:14px">A <code>.dbc</code> says who
      <b>sends</b> each message, but not which of those nodes is the box you are
      holding &mdash; and that is the whole difference between a reading and a
      command. Answer it and <b>Fill</b> puts what your node sends on the
      <b>Send</b> tab and everything else on the <b>dashboard</b>.
      <br><br>The answer is <b>per bus</b>: this logger is often a node on one
      bus and only a listener on the other, and the two frame maps name
      different nodes anyway.
      <br><br>Recording never changes: every frame that arrives is logged
      whoever the file says sends it.</div>

    <div id="rolelist"></div>
    <div class="sub" id="rolenote">&nbsp;</div>

    <div class="acts">
      <button id="role_close" class="pri">Done</button>
    </div>
  </div>
</div>

<!-- will this dashboard still answer while the logger records? -->
<div class="sheet" id="websheet">
  <div class="sheetbox">
    <h3>Will this dashboard still answer while it records?</h3>
    <div class="sub" style="margin-bottom:14px">The frame maps and this web
      server come out of the same memory. A big map does not stop the logger
      <b>recording</b> &mdash; every frame is captured whole whatever happens
      here &mdash; but it can leave the board unable to accept a connection, and
      then this page stops loading a minute into the run and does not come back.
      <br><br>There are two answers and no middle one. In the band between them
      the same map served 46%, 3%, 95%, 3% and 99.9% on five consecutive runs,
      so &ldquo;probably&rdquo; would describe the run rather than the choice
      &mdash; and it is the choice being made here.</div>

    <div class="card" style="margin-bottom:14px">
      <div class="state"><span class="dot" id="webdot"></span>
        <div><div class="big" id="webhead">&mdash;</div>
             <div class="sub" id="webwhy">&nbsp;</div></div></div>
    </div>

    <div class="card" style="margin-bottom:14px" id="webnmcard">
      <h2>Longest signal name kept</h2>
      <div class="sub" style="margin:0 0 8px">The single biggest lever on the
        memory a map costs. Shorter names are <b>abbreviated</b>, not clipped
        &mdash; <code>EngineCoolantTemperature</code> becomes <code>EngCoolTemp</code>
        &mdash; and the layout references are rewritten to match, so nothing
        stops resolving.</div>
      <div class="step" id="webnm"></div>
    </div>

    <div id="webfix"></div>

    <div class="acts">
      <button id="web_close" class="pri">Done</button>
    </div>
  </div>
</div>

<input type="file" id="filepick" accept=".bundle,.cfg,.txt,text/plain" hidden>
<input type="file" id="dbcpick" accept=".dbc,text/plain" hidden>
)HTML";

/* ==========================================================================
 *  PART 3 - the widget engine, the layout format, and polling.
 *
 *  The widgets are hand-drawn SVG because the page has to work from a hotspot
 *  with no route to the internet, which rules out every gauge library there is.
 *  They are built ONCE, when a cell is created, and afterwards an update only
 *  moves a needle and rewrites one string - no innerHTML, no re-layout, which
 *  is what makes five updates a second cost nothing on the browser side.
 *
 *  On the logger's side the cost is one request carrying only the cells that
 *  exist, and only for the tab that is actually on screen. A backgrounded
 *  browser tab polls nothing at all.
 * ======================================================================== */
static const char PAGE_3[] PROGMEM = R"HTML(<script>
"use strict";
var NS = 'http://www.w3.org/2000/svg';
function q(id){ return document.getElementById(id); }
function el(tag, cls, txt){
  var e = document.createElement(tag);
  if(cls) e.className = cls;
  if(txt !== undefined) e.textContent = txt;
  return e;
}
function sv(tag, attrs){
  var e = document.createElementNS(NS, tag), k;
  for(k in attrs) e.setAttribute(k, attrs[k]);
  return e;
}
function esc(s){
  return String(s).replace(/[&<>]/g, function(c){
    return c === '&' ? '&amp;' : (c === '<' ? '&lt;' : '&gt;');
  });
}
function hms(s){
  var h = Math.floor(s/3600), m = Math.floor(s/60)%60, x = s%60;
  return (h<10?'0':'')+h+':'+(m<10?'0':'')+m+':'+(x<10?'0':'')+x;
}

/* ---------------------------------------------------------------------------
 *  The layout, in the same text format the card holds.
 *
 *  Parsed and written here as well as on the logger, deliberately: it means
 *  Export is literally what the device stores, Import is the same bytes going
 *  back, and there is no second representation that could disagree with the
 *  first. The device re-serialises whatever it receives, so its writer stays
 *  the one that decides the canonical form.
 * -------------------------------------------------------------------------*/
/* roles[] is indexed 0-based by bus, like DBCS[]. One per bus and not one
   shared answer: each bus has its own frame map and so its own BU_ node list,
   and this logger is very often a node on one bus and a pure listener on the
   other. A single role could not even be read - the button said "Role: Tester"
   without saying which bus that was about. */
var CFG = { cols:4, rows:2, poll:200, roles:['',''], cells:{}, tx:{} };
/* How many cells this firmware can store. Told to us by /api/dash rather than
   written down here, so the two cannot drift apart. */
var MAXCELLS = 48, MAXSEND = 32;
/* How many controllers this firmware has. Kept in one place so the page has a
   single answer, and so a third bus would be a number rather than a rewrite. */
var NBUS  = 2;

/* One frame map per bus, fetched on demand and cached. DBC is whichever of
   them the OPEN EDITOR is about - every dialog edits one cell or one setpoint,
   and that belongs to exactly one bus, so the twenty places that read DBC.m
   stay as they are and only the swap has to be got right. */
var DBCS  = [null, null];
var DBC   = { loaded:0, m:[] };
var EDBUS = 1;                    /* the bus the open editor is working on */
var BUS   = 1;                    /* the bus the Bus tab is showing        */

function edBus(){ return EDBUS; }
var GEN = 0;

function cellsCount(){ return Math.min(CFG.cols * CFG.rows, MAXCELLS); }

/* Slots are one flat list drawn left to right, top to bottom, so taking a cell
   out of the middle leaves a hole in that list. Close it by pulling everything
   after it back one place - which is what "shift the ones in front up" means
   on a grid. Gaps BEFORE the removed slot are left alone: those are ones
   somebody made on purpose by dragging, and closing them would rearrange a
   layout the operator had already settled. */
function removeCell(slot){
  delete CFG.cells[slot];
  Object.keys(CFG.cells).map(Number).sort(function(a, b){ return a - b; })
    .forEach(function(k){
      if(k > slot){ CFG.cells[k - 1] = CFG.cells[k]; delete CFG.cells[k]; }
    });
}

/* Splits a line into key=value pairs, honouring quotes so a title can contain
 * spaces. Mirrors nextPair() in dash.cpp. */
function pairs(rest){
  var out = {}, i = 0, n = rest.length;
  while(i < n){
    while(i < n && /\s/.test(rest[i])) i++;
    if(i >= n) break;
    var k = '';
    while(i < n && rest[i] !== '=' && !/\s/.test(rest[i])) k += rest[i++];
    var v = '';
    if(rest[i] === '='){
      i++;
      if(rest[i] === '"'){
        i++;
        while(i < n && rest[i] !== '"') v += rest[i++];
        if(rest[i] === '"') i++;
      } else {
        while(i < n && !/\s/.test(rest[i])) v += rest[i++];
      }
    }
    if(k) out[k] = v;
  }
  return out;
}
function numOr(v, dflt){
  if(v === undefined || v === '') return dflt;
  var f = parseFloat(v);
  return isFinite(f) ? f : dflt;
}

/* Which bus a cell or setpoint belongs to, as the file writes it: one-based,
   and absent means bus 1. Kept one-based on the client too, because every
   label the operator sees says CAN 1 and CAN 2 and a page that counted from
   zero internally would eventually show it. */
function busOr(v){
  var n = parseInt(v, 10);
  return (n >= 1 && n <= NBUS) ? n : 1;
}

function parseCfg(text){
  var c = { cols:4, rows:2, poll:200, roles:['',''], cells:{}, tx:{} };
  text.split(/\r?\n/).forEach(function(line){
    line = line.replace(/^\s+/, '');
    if(!line || line[0] === '#') return;
    var sp = line.indexOf(' ');
    if(sp < 0) return;
    var kw = line.slice(0, sp), rest = line.slice(sp + 1);

    if(kw === 'grid'){
      var g = rest.trim().split(/\s+/);
      c.cols = Math.max(1, Math.min(6, parseInt(g[0], 10) || 4));
      c.rows = Math.max(1, Math.min(8, parseInt(g[1], 10) || 2));
    } else if(kw === 'poll'){
      c.poll = Math.max(100, Math.min(5000, parseInt(rest, 10) || 200));
    } else if(kw === 'role' || kw === 'node'){
      /* 'node' is what this was called in an earlier version. Reading both
         means a setup file from any of them keeps its answer.

         The name comes first and an optional bus= follows, in the same form
         and with the same default as a cell: absent means bus 1. So every
         `role "Tester"` line ever written still means what it meant. */
      var rm = rest.match(/^\s*("([^"]*)"|\S+)\s*(.*)$/);
      if(rm){
        c.roles[busOr(pairs(rm[3] || '').bus) - 1] =
          (rm[2] !== undefined ? rm[2] : rm[1]);
      }
    } else if(kw === 'cell' || kw === 'send'){
      var sp2 = rest.indexOf(' ');
      if(sp2 < 0) return;
      var idx = parseInt(rest.slice(0, sp2), 10);
      var p = pairs(rest.slice(sp2 + 1));
      if(!isFinite(idx)) return;

      if(kw === 'cell'){
        if(!p.sig) return;
        c.cells[idx] = {
          w: p.widget || 'number', sig: p.sig, b: busOr(p.bus),
          label: p.label || '', unit: p.unit || '',
          lo: numOr(p.lo, 0), hi: numOr(p.hi, 100),
          dec: p.dec === undefined ? null : parseInt(p.dec, 10),
          warn: p.warn === undefined ? null : numOr(p.warn, null),
          crit: p.crit === undefined ? null : numOr(p.crit, null),
          lowbad: p.lowbad === '1' ? 1 : 0
        };
      } else {
        if(!p.label) return;
        c.tx[idx] = {
          label: p.label, sig: p.sig || '', b: busOr(p.bus), unit: p.unit || '',
          lo: numOr(p.lo, 0), hi: numOr(p.hi, 0),
          step: numOr(p.step, 1), preset: numOr(p.preset, 0),
          dec: p.dec === undefined ? null : parseInt(p.dec, 10),
          style: p.style || 'number', choices: p.choices || '',
          id: p.id || '', data: p.data || '', ext: p.ext === '1' ? 1 : 0,
          cyclic: numOr(p.cyclic, 0),
          /* The manual override: which signal of this message selects the
             payload, and which code this value travels under. Both or
             neither - a selector with no code cannot build a frame. */
          msel: p.msel || '',
          mxc: p.mxc === undefined ? null : (parseInt(p.mxc, 10) || 0),
          raw: p.id !== undefined || p.data !== undefined
        };
        /* 'mux=1' is what an earlier version wrote to mark a value as one
           payload of a multiplexed message. The message name and the frame map
           say that now, so it is read and not written back. */
      }
    }
  });
  return c;
}

function quote(v){
  v = String(v === undefined || v === null ? '' : v).replace(/["\n]/g, '');
  return (v === '' || /\s/.test(v)) ? '"' + v + '"' : v;
}
function trimNum(v){
  var s = (Math.round(v * 1000) / 1000).toFixed(3);
  return s.replace(/\.?0+$/, '') || '0';
}

function dumpCfg(){
  var out = ['version 1', 'grid ' + CFG.cols + ' ' + CFG.rows, 'poll ' + CFG.poll];
  /* One line per bus with an answer, bus= only when it is not bus 1 - the
     rule the cells and setpoints follow, and the firmware writes it the same
     way. */
  CFG.roles.forEach(function(r, i){
    if(r) out.push('role ' + quote(r) + (i ? ' bus=' + (i + 1) : ''));
  });
  Object.keys(CFG.cells).map(Number).sort(function(a,b){return a-b;}).forEach(function(i){
    var c = CFG.cells[i];
    if(!c || !c.sig) return;
    var s = 'cell ' + i + ' widget=' + c.w + ' sig=' + quote(c.sig);
    /* Only when it is not bus 1, so a single-bus layout round trips to exactly
       the file it came from - the firmware writes it the same way. */
    if(c.b > 1) s += ' bus=' + c.b;
    if(c.label) s += ' label=' + quote(c.label);
    if(c.unit)  s += ' unit=' + quote(c.unit);
    s += ' lo=' + trimNum(c.lo) + ' hi=' + trimNum(c.hi);
    if(c.dec !== null && c.dec !== undefined && isFinite(c.dec)) s += ' dec=' + c.dec;
    if(c.warn !== null && c.warn !== undefined) s += ' warn=' + trimNum(c.warn);
    if(c.crit !== null && c.crit !== undefined) s += ' crit=' + trimNum(c.crit);
    if(c.lowbad) s += ' lowbad=1';
    out.push(s);
  });
  Object.keys(CFG.tx).map(Number).sort(function(a,b){return a-b;}).forEach(function(i){
    var t = CFG.tx[i];
    if(!t || !t.label) return;
    var s = 'send ' + i + ' label=' + quote(t.label);
    if(t.b > 1) s += ' bus=' + t.b;
    if(t.raw){
      s += ' id=' + (t.id || '0x000');
      if(t.ext) s += ' ext=1';
      s += ' data=' + (t.data || '');
    } else {
      if(!t.sig) return;
      s += ' sig=' + quote(t.sig);
      if(t.unit) s += ' unit=' + quote(t.unit);
      s += ' lo=' + trimNum(t.lo) + ' hi=' + trimNum(t.hi) +
           ' step=' + trimNum(t.step) + ' preset=' + trimNum(t.preset);
      if(t.dec !== null && t.dec !== undefined && isFinite(t.dec)) s += ' dec=' + t.dec;
      s += ' style=' + (t.style || 'number');
      if(t.choices) s += ' choices=' + quote(t.choices);
    }
    if(t.msel){
      s += ' msel=' + quote(t.msel) + ' mxc='
         + ((t.mxc === null || t.mxc === undefined) ? 0 : Math.round(t.mxc));
    }
    if(t.cyclic) s += ' cyclic=' + Math.round(t.cyclic);
    out.push(s);
  });
  return out.join('\n') + '\n';
}

/* ---------------------------------------------------------------------------
 *  Drawing
 * -------------------------------------------------------------------------*/
function clamp01(x){ return x < 0 ? 0 : (x > 1 ? 1 : x); }
function frac(c, v){
  var span = c.hi - c.lo;
  return span > 0 ? clamp01((v - c.lo) / span) : 0;
}
function decOf(c){
  if(c.dec !== null && c.dec !== undefined && isFinite(c.dec)) return c.dec;
  var span = Math.abs(c.hi - c.lo);
  return span >= 200 ? 0 : (span >= 20 ? 1 : 2);
}
function fmtVal(v, d){
  if(!isFinite(v)) return '--';
  return v.toFixed(d);
}
/* Tick labels have to fit in nine pixels of a dial, so they lose the decimals
   the readout keeps. */
function tickLabel(v){
  var a = Math.abs(v);
  if(a >= 1000) return (v / 1000).toFixed(a >= 10000 ? 0 : 1) + 'k';
  if(a >= 10 || v === 0) return v.toFixed(0);
  if(a >= 1) return v.toFixed(1);
  return v.toFixed(2);
}

/* Where the coloured bands sit, in value space. With lowbad set the dangerous
   end is the bottom - a hydraulic level or a pressure that must not drop - and
   the bands run the other way. */
function zoneSpans(c){
  var out = [];
  if(c.lowbad){
    if(c.warn !== null && c.warn !== undefined) out.push({a:c.lo, b:c.warn, k:'warn'});
    if(c.crit !== null && c.crit !== undefined) out.push({a:c.lo, b:c.crit, k:'bad'});
  } else {
    if(c.warn !== null && c.warn !== undefined) out.push({a:c.warn, b:c.hi, k:'warn'});
    if(c.crit !== null && c.crit !== undefined) out.push({a:c.crit, b:c.hi, k:'bad'});
  }
  return out;
}
function zoneOf(c, v){
  if(!isFinite(v)) return 'ok';
  var w = c.warn, r = c.crit;
  if(c.lowbad){
    if(r !== null && r !== undefined && v <= r) return 'bad';
    if(w !== null && w !== undefined && v <= w) return 'warn';
  } else {
    if(r !== null && r !== undefined && v >= r) return 'bad';
    if(w !== null && w !== undefined && v >= w) return 'warn';
  }
  return 'ok';
}
function zoneColour(k){
  return k === 'bad' ? 'var(--bad)' : (k === 'warn' ? 'var(--warn)' : 'var(--acc)');
}

function pol(cx, cy, r, deg){
  var a = (deg - 90) * Math.PI / 180;
  return [cx + r * Math.cos(a), cy + r * Math.sin(a)];
}
function arcp(cx, cy, r, a0, a1){
  var p = pol(cx, cy, r, a0), s = pol(cx, cy, r, a1);
  return 'M' + p[0].toFixed(2) + ' ' + p[1].toFixed(2) +
         'A' + r + ' ' + r + ' 0 ' + (Math.abs(a1 - a0) > 180 ? 1 : 0) + ' ' +
         (a1 > a0 ? 1 : 0) + ' ' + s[0].toFixed(2) + ' ' + s[1].toFixed(2);
}
function spin(node, cx, cy){
  node.setAttribute('style', 'transform-box:view-box;transform-origin:' +
    cx + 'px ' + cy + 'px;transition:transform var(--tt) linear');
}

/* A dial: the shape behind the speedometer, the half-gauge and the centre-zero
   angle indicator. They differ only in how far they sweep and where the value
   arc starts from. */
function dial(c, o){
  var g = sv('svg', {viewBox:o.vb, preserveAspectRatio:'xMidYMid meet'});
  var a0 = o.a0, a1 = o.a1, span = a1 - a0;
  function ang(v){ return a0 + span * frac(c, v); }

  g.appendChild(sv('path', {d:arcp(o.cx,o.cy,o.r,a0,a1), fill:'none',
    stroke:'var(--track)', 'stroke-width':9, 'stroke-linecap':'round'}));

  zoneSpans(c).forEach(function(z){
    var s = ang(z.a), e = ang(z.b);
    if(Math.abs(e - s) < 0.5) return;
    g.appendChild(sv('path', {d:arcp(o.cx,o.cy,o.r,Math.min(s,e),Math.max(s,e)),
      fill:'none', stroke:z.k === 'bad' ? 'var(--bad)' : 'var(--warn)',
      'stroke-width':9, opacity:0.8}));
  });

  /* The reading, as an arc. On a centre-zero dial it grows out of the middle
     in whichever direction the value went, which is what makes a steering
     angle readable at a glance instead of requiring the number to be read. */
  var base = o.centre ? a0 + span / 2 : a0;
  var lead = sv('path', {fill:'none', stroke:'var(--acc)', 'stroke-width':9,
    'stroke-linecap':'round', d:''});
  g.appendChild(lead);

  var n = o.ticks || 5;
  for(var i = 0; i <= n; i++){
    var t = a0 + span * i / n;
    var p1 = pol(o.cx, o.cy, o.r - 7, t), p2 = pol(o.cx, o.cy, o.r - 16, t);
    g.appendChild(sv('line', {x1:p1[0].toFixed(1), y1:p1[1].toFixed(1),
      x2:p2[0].toFixed(1), y2:p2[1].toFixed(1),
      stroke:(o.centre && i * 2 === n) ? 'var(--txt)' : 'var(--dim)',
      'stroke-width':(o.centre && i * 2 === n) ? 2.4 : 1.6}));

    var lp = pol(o.cx, o.cy, o.r + 13, t);
    var tl = sv('text', {x:lp[0].toFixed(1), y:(lp[1] + 3.2).toFixed(1),
      fill:'var(--dim)', 'font-size':9, 'text-anchor':'middle'});
    tl.textContent = tickLabel(c.lo + (c.hi - c.lo) * i / n);
    g.appendChild(tl);

    if(i < n){
      for(var m = 1; m < 4; m++){
        var mt = t + (span / n) * (m / 4);
        var q1 = pol(o.cx, o.cy, o.r - 7, mt), q2 = pol(o.cx, o.cy, o.r - 11, mt);
        g.appendChild(sv('line', {x1:q1[0].toFixed(1), y1:q1[1].toFixed(1),
          x2:q2[0].toFixed(1), y2:q2[1].toFixed(1),
          stroke:'var(--line)', 'stroke-width':1.2}));
      }
    }
  }

  var needle = sv('g', {});
  needle.appendChild(sv('path', {fill:'var(--txt)',
    d:'M' + (o.cx - 3.4) + ' ' + o.cy + 'L' + o.cx + ' ' + (o.cy - (o.r - 13)) +
      'L' + (o.cx + 3.4) + ' ' + o.cy + 'Z'}));
  needle.appendChild(sv('circle', {cx:o.cx, cy:o.cy, r:5, fill:'var(--txt)'}));
  needle.appendChild(sv('circle', {cx:o.cx, cy:o.cy, r:2.2, fill:'var(--panel)'}));
  spin(needle, o.cx, o.cy);
  g.appendChild(needle);

  return {node:g, set:function(v, txt, z){
    var a = isFinite(v) ? ang(v) : a0;
    needle.style.transform = 'rotate(' + a.toFixed(2) + 'deg)';
    lead.setAttribute('stroke', zoneColour(z));
    if(!isFinite(v) || Math.abs(a - base) < 0.5){ lead.setAttribute('d', ''); }
    else { lead.setAttribute('d',
      arcp(o.cx, o.cy, o.r, Math.min(base, a), Math.max(base, a))); }
  }};
}

function compass(c){
  var cx = 74, cy = 74, r = 48;
  var g = sv('svg', {viewBox:'0 0 148 148', preserveAspectRatio:'xMidYMid meet'});
  g.appendChild(sv('circle', {cx:cx, cy:cy, r:r, fill:'none',
    stroke:'var(--track)', 'stroke-width':9}));

  var marks = ['0', '45', '90', '135', '180', '225', '270', '315'];
  for(var i = 0; i < 8; i++){
    var a = i * 45;
    var p1 = pol(cx, cy, r - 6, a), p2 = pol(cx, cy, r - (i % 2 ? 11 : 15), a);
    g.appendChild(sv('line', {x1:p1[0].toFixed(1), y1:p1[1].toFixed(1),
      x2:p2[0].toFixed(1), y2:p2[1].toFixed(1),
      stroke:i % 2 ? 'var(--line)' : 'var(--dim)', 'stroke-width':i % 2 ? 1.2 : 1.8}));
    if(i % 2 === 0){
      var lp = pol(cx, cy, r + 13, a);
      var t = sv('text', {x:lp[0].toFixed(1), y:(lp[1] + 3.2).toFixed(1),
        fill:'var(--dim)', 'font-size':9, 'text-anchor':'middle'});
      t.textContent = marks[i];
      g.appendChild(t);
    }
  }

  var needle = sv('g', {});
  needle.appendChild(sv('path', {fill:'var(--acc)',
    d:'M' + cx + ' ' + (cy - (r - 14)) + 'L' + (cx - 6) + ' ' + cy +
      'L' + (cx + 6) + ' ' + cy + 'Z'}));
  needle.appendChild(sv('path', {fill:'var(--dim)',
    d:'M' + cx + ' ' + (cy + (r - 22)) + 'L' + (cx - 5) + ' ' + cy +
      'L' + (cx + 5) + ' ' + cy + 'Z'}));
  needle.appendChild(sv('circle', {cx:cx, cy:cy, r:4.4, fill:'var(--txt)'}));
  spin(needle, cx, cy);
  g.appendChild(needle);

  return {node:g, set:function(v, txt, z){
    /* A compass reads all the way round, so the configured range maps onto a
       full turn rather than onto a sweep with a dead sector at the bottom. */
    var deg = isFinite(v) ? frac(c, v) * 360 : 0;
    needle.style.transform = 'rotate(' + deg.toFixed(2) + 'deg)';
    needle.firstChild.setAttribute('fill', zoneColour(z));
  }};
}

/* One builder for the horizontal bar and the vertical tank: same track, same
   fill, same bands, rotated. */
function bar(c, vert){
  var g, track, fill, L = 168;
  if(vert){
    g = sv('svg', {viewBox:'0 0 84 126', preserveAspectRatio:'xMidYMid meet'});
    L = 108;
    track = sv('rect', {x:26, y:8, width:32, height:L, rx:11, fill:'var(--track)'});
    fill  = sv('rect', {x:26, y:8 + L, width:32, height:0, rx:11, fill:'var(--acc)'});
  } else {
    g = sv('svg', {viewBox:'0 0 200 48', preserveAspectRatio:'xMidYMid meet'});
    track = sv('rect', {x:8, y:12, width:L + 16, height:17, rx:8.5, fill:'var(--track)'});
    fill  = sv('rect', {x:8, y:12, width:0, height:17, rx:8.5, fill:'var(--acc)'});
  }
  g.appendChild(track);

  zoneSpans(c).forEach(function(z){
    var f0 = frac(c, Math.min(z.a, z.b)), f1 = frac(c, Math.max(z.a, z.b));
    if(f1 - f0 < 0.01) return;
    var col = z.k === 'bad' ? 'var(--bad)' : 'var(--warn)';
    if(vert){
      g.appendChild(sv('rect', {x:26, y:(8 + L - f1 * L).toFixed(1), width:32,
        height:((f1 - f0) * L).toFixed(1), fill:col, opacity:0.22}));
    } else {
      g.appendChild(sv('rect', {x:(8 + 8 + f0 * L).toFixed(1), y:12,
        width:((f1 - f0) * L).toFixed(1), height:17, fill:col, opacity:0.22}));
    }
  });
  g.appendChild(fill);
  fill.setAttribute('style', 'transition:width var(--tt) linear,' +
                             'height var(--tt) linear,y var(--tt) linear');

  var lo = sv('text', {fill:'var(--dim)', 'font-size':9});
  var hi = sv('text', {fill:'var(--dim)', 'font-size':9});
  if(vert){
    lo.setAttribute('x', 64); lo.setAttribute('y', 8 + L);
    hi.setAttribute('x', 64); hi.setAttribute('y', 14);
  } else {
    lo.setAttribute('x', 8);   lo.setAttribute('y', 43);
    hi.setAttribute('x', 192); hi.setAttribute('y', 43);
    hi.setAttribute('text-anchor', 'end');
  }
  lo.textContent = tickLabel(c.lo);
  hi.textContent = tickLabel(c.hi);
  g.appendChild(lo); g.appendChild(hi);

  return {node:g, set:function(v, txt, z){
    var f = isFinite(v) ? frac(c, v) : 0;
    if(vert){
      fill.setAttribute('height', (f * L).toFixed(1));
      fill.setAttribute('y', (8 + L - f * L).toFixed(1));
    } else {
      fill.setAttribute('width', (f * (L + 16)).toFixed(1));
    }
    fill.setAttribute('fill', zoneColour(z));
  }};
}

function thermo(c){
  var g = sv('svg', {viewBox:'0 0 124 132', preserveAspectRatio:'xMidYMid meet'});
  var top = 10, H = 74, x = 44, w = 22, bx = x + w / 2, by = top + H + 24, br = 19;

  g.appendChild(sv('rect', {x:x, y:top, width:w, height:H + 16, rx:w / 2,
    fill:'var(--track)'}));
  g.appendChild(sv('circle', {cx:bx, cy:by, r:br, fill:'var(--track)'}));

  /* Beside the tube, not over it: a band painted across the glass reads as
     something inside the thermometer rather than as a mark on the scale. */
  zoneSpans(c).forEach(function(z){
    var f0 = frac(c, Math.min(z.a, z.b)), f1 = frac(c, Math.max(z.a, z.b));
    if(f1 - f0 < 0.01) return;
    g.appendChild(sv('rect', {x:x + w + 3, y:(top + H - f1 * H).toFixed(1),
      width:5, height:((f1 - f0) * H).toFixed(1), rx:2.5,
      fill:z.k === 'bad' ? 'var(--bad)' : 'var(--warn)', opacity:0.75}));
  });

  var col  = sv('rect', {x:x + 5, y:top + H, width:w - 10, height:0,
    fill:'var(--acc)'});
  var bulb = sv('circle', {cx:bx, cy:by, r:br - 5, fill:'var(--acc)'});
  col.setAttribute('style', 'transition:height var(--tt) linear,y var(--tt) linear');
  g.appendChild(col);
  g.appendChild(bulb);

  for(var i = 0; i <= 4; i++){
    var y = top + H - (H * i / 4);
    g.appendChild(sv('line', {x1:x - 9, y1:y, x2:x - 3, y2:y,
      stroke:'var(--line)', 'stroke-width':1.5}));
    var t = sv('text', {x:x - 12, y:y + 3.2, fill:'var(--dim)', 'font-size':9,
      'text-anchor':'end'});
    t.textContent = tickLabel(c.lo + (c.hi - c.lo) * i / 4);
    g.appendChild(t);
  }

  return {node:g, set:function(v, txt, z){
    var f = isFinite(v) ? frac(c, v) : 0;
    col.setAttribute('height', (f * H).toFixed(1));
    col.setAttribute('y', (top + H - f * H).toFixed(1));
    col.setAttribute('fill', zoneColour(z));
    bulb.setAttribute('fill', zoneColour(z));
  }};
}

/* A number and where it has been. The history lives in the browser: the logger
   sends one value per poll and never has to remember anything. */
function spark(c){
  var W = 196, H = 54, N = 90;
  var g = sv('svg', {viewBox:'0 0 200 60', preserveAspectRatio:'none'});
  var line = sv('polyline', {fill:'none', stroke:'var(--acc)', 'stroke-width':2,
    'stroke-linejoin':'round', 'stroke-linecap':'round', points:''});
  var area = sv('polygon', {fill:'var(--acc)', opacity:0.13, points:''});
  g.appendChild(sv('line', {x1:2, y1:H/2 + 3, x2:W, y2:H/2 + 3,
    stroke:'var(--line)', 'stroke-width':1, 'stroke-dasharray':'3 4'}));
  g.appendChild(area); g.appendChild(line);
  var dot = sv('circle', {cx:-9, cy:0, r:3, fill:'var(--acc)'});
  g.appendChild(dot);

  var hist = [];
  return {node:g, set:function(v, txt, z){
    if(isFinite(v)) hist.push(v);
    while(hist.length > N) hist.shift();
    if(hist.length < 2){ line.setAttribute('points', ''); return; }

    /* Newest at the right, growing leftwards, so the trace is anchored where
       the eye looks for "now" and a half-full history is a short line at the
       right rather than a stub in the corner. */
    var pts = '', i, x, y, first = W;
    for(i = 0; i < hist.length; i++){
      x = W - (hist.length - 1 - i) * ((W - 4) / (N - 1));
      y = 3 + (H - 6) * (1 - frac(c, hist[i]));
      if(i === 0) first = x;
      pts += x.toFixed(1) + ',' + y.toFixed(1) + ' ';
    }
    line.setAttribute('points', pts);
    area.setAttribute('points', first.toFixed(1) + ',' + (H + 3) + ' ' + pts +
                                x.toFixed(1) + ',' + (H + 3));
    line.setAttribute('stroke', zoneColour(z));
    area.setAttribute('fill', zoneColour(z));
    dot.setAttribute('cx', x.toFixed(1));
    dot.setAttribute('cy', y.toFixed(1));
    dot.setAttribute('fill', zoneColour(z));
  }};
}

/* A named state rather than a number: a gear, a mode, a fault line. The colour
   is guessed from the word, because the DBC says what a value is called and
   never says whether it is good news. */
var GOOD = /^(off|ok|normal|none|ready|idle|forward|closed|inactive|no|0|false)$/i;
var BUSY = /^(on|run|running|active|open|enabled|yes|1|true|auto|drive)$/i;
var BAD  = /(fault|error|fail|alarm|emerg|overheat|overload|critical|stop|trip|bad)/i;
var WARNW = /(warn|caution|degrad|limit|reduced|service)/i;
function pill(c){
  var p = el('div', 'pill', '--');
  return {node:p, set:function(v, txt, z){
    var s = (txt === null || txt === undefined || txt === '') ? '--' : String(txt);
    p.textContent = s;
    var k = 'p-acc';
    if(z === 'bad' || BAD.test(s)) k = 'p-bad';
    else if(z === 'warn' || WARNW.test(s)) k = 'p-warn';
    else if(GOOD.test(s)) k = 'p-ok';
    else if(BUSY.test(s)) k = 'p-acc';
    p.className = 'pill ' + k;
  }};
}

var WIDGETS = [
  {id:'gauge',   name:'Gauge',   hint:'speed, rpm, flow'},
  {id:'arc',     name:'Half',    hint:'pressure, load'},
  {id:'angle',   name:'Angle',   hint:'steering, tilt'},
  {id:'compass', name:'Compass', hint:'heading, yaw'},
  {id:'bar',     name:'Bar',     hint:'percentages'},
  {id:'level',   name:'Tank',    hint:'fuel, oil level'},
  {id:'thermo',  name:'Temp',    hint:'temperatures'},
  {id:'number',  name:'Number',  hint:'anything'},
  {id:'spark',   name:'Trend',   hint:'drift over time'},
  {id:'state',   name:'State',   hint:'gear, mode, faults'}
];

function makeWidget(c){
  switch(c.w){
    case 'gauge':   return dial(c, {vb:'0 0 200 132', cx:100, cy:86, r:60, a0:-120, a1:120, ticks:5});
    case 'arc':     return dial(c, {vb:'0 0 200 100', cx:100, cy:86, r:60, a0:-90, a1:90, ticks:4});
    case 'angle':   return dial(c, {vb:'0 0 200 104', cx:100, cy:88, r:60, a0:-80, a1:80, ticks:4, centre:true});
    case 'compass': return compass(c);
    case 'bar':     return bar(c, false);
    case 'level':   return bar(c, true);
    case 'thermo':  return thermo(c);
    case 'spark':   return spark(c);
    case 'state':   return pill(c);
    default:        return {node:null, set:function(){}};
  }
}

function sigName(ref){
  var dot = String(ref || '').lastIndexOf('.');
  return dot < 0 ? String(ref || '') : ref.slice(dot + 1);
}
function cellTitle(c){ return c.label || sigName(c.sig); }
</script>
)HTML";

/* ==========================================================================
 *  PART 4 - the application: tabs, the grid, customization, diagnostics.
 * ======================================================================== */
static const char PAGE_4[] PROGMEM = R"HTML(<script>
"use strict";
var TAB = 'dash', EDIT = false, cellObjs = {}, timers = [], fails = 0, seq = 0;
var LIVE = {};            /* Message.Signal -> latest text, for the editors  */
var lastTicket = 0, ARMED = false, ARMLEFT = 0, CYC = 0, CANTX = 1;

function postForm(url, obj){
  var b = Object.keys(obj).map(function(k){
    return encodeURIComponent(k) + '=' + encodeURIComponent(obj[k]);
  }).join('&');
  return fetch(url, {method:'POST',
    headers:{'Content-Type':'application/x-www-form-urlencoded'}, body:b});
}
function toast(title, msg, kind){
  var t = el('div', 'toast' + (kind ? ' ' + kind : ''));
  t.appendChild(el('b', null, title));
  t.appendChild(document.createTextNode(msg));
  q('toasts').appendChild(t);
  setTimeout(function(){
    t.style.opacity = 0;
    t.style.transition = 'opacity .3s';
    setTimeout(function(){ if(t.parentNode) t.remove(); }, 320);
  }, 4200);
}
function setDot(id, cls){ q(id).className = 'dot ' + cls; }

/* ---- tabs -------------------------------------------------------------- *
 * Only the visible tab is polled, and a backgrounded browser polls nothing.
 * The Dashboard needs exactly one request per update because /api/dash now
 * carries the health counters as well as the cell values - the two big tables
 * that make /api/status expensive are only on the Bus tab, which is the only
 * tab that shows them.                                                      */
var TABS = ['dash','bus','send','log'];
function showTab(name){
  if(TABS.indexOf(name) < 0) name = 'dash';
  TAB = name;
  /* In the address bar, so a tab can be bookmarked - "open the logger on the
     log" is a reasonable thing to want on a machine you visit often. */
  if(location.hash.slice(1) !== name) history.replaceState(null, '', '#' + name);
  TABS.forEach(function(n){ q('v_' + n).hidden = (n !== name); });
  Array.prototype.forEach.call(q('tabs').children, function(b){
    b.classList.toggle('on', b.dataset.tab === name);
  });
  /* The Send tab needs the frame map: a value whose input is "pick from the
     frame map's own names" cannot draw its list without it, and would silently
     fall back to a number box - which is the one input this feature exists to
     avoid. */
  if(name === 'send') loadDbc().then(renderSend);
  startPolls();
}
function stopPolls(){ timers.forEach(clearInterval); timers = []; }
function startPolls(){
  stopPolls();
  if(document.hidden) return;

  if(TAB === 'dash'){
    /* While the grid is being customized nothing on it is showing a live value
       - the cells are placeholders being dragged around - so the fast poll is
       pointless work for the logger. Drop to a heartbeat that only keeps the
       health cards and the connection indicator honest. */
    pollDash();
    timers.push(setInterval(pollDash, EDIT ? 2000 : CFG.poll));
  } else if(TAB === 'bus'){
    pollStatus();
    timers.push(setInterval(pollStatus, 600));
  } else if(TAB === 'send'){
    pollDash();
    timers.push(setInterval(pollDash, 700));
  } else {
    pollLog(); pollDash();
    timers.push(setInterval(pollLog, 700));
    timers.push(setInterval(pollDash, 3000));
  }
}
document.addEventListener('visibilitychange', startPolls);

/* ---- building the grid ------------------------------------------------- */
function buildCell(slot){
  var c = CFG.cells[slot];
  var e = el('div', 'cell slot');
  e.dataset.slot = slot;

  if(!c){
    e.className = 'cell slot empty';
    e.appendChild(el('div', null, '+'));
    e.appendChild(el('div', null, 'Add a value'));
    return {el:e, empty:true};
  }

  var tools = el('div', 'tools');
  var bEdit = el('button', null, '✎'); bEdit.title = 'Edit this cell';
  var bDel  = el('button', null, '×'); bDel.title = 'Remove this cell';
  bEdit.dataset.act = 'edit'; bDel.dataset.act = 'del';
  tools.appendChild(bEdit); tools.appendChild(bDel);
  e.appendChild(tools);

  /* Badged only when it is NOT bus 1. On a dashboard where most cells come
     from one bus, marking every cell would be noise; marking the exceptions is
     the information. A one-bus dashboard looks exactly as it did. */
  if((c.b || 1) > 1){
    var badge = el('div', 'cbus', 'CAN ' + c.b);
    e.appendChild(badge);
  }

  e.appendChild(el('div', 'cname', cellTitle(c)));

  var w = makeWidget(c);
  var gfx = el('div', 'gfx');
  if(w.node) gfx.appendChild(w.node);
  else       e.classList.add('plain');   /* nothing drawn: the number IS the cell */
  e.appendChild(gfx);

  var val = el('div', 'cval' + (w.node && c.w !== 'state' ? '' : ' big'),
               c.w === 'state' ? '' : '--');
  if(c.w === 'state') val.style.display = 'none';
  e.appendChild(val);
  e.appendChild(el('div', 'cunit', c.w === 'state' ? '' : (c.unit || '')));

  return {el:e, w:w, val:val, unit:e.lastChild, cfg:c};
}

function renderGrid(){
  var g = q('grid');
  g.innerHTML = '';
  cellObjs = {};
  g.style.setProperty('--cols', CFG.cols);
  document.documentElement.style.setProperty('--tt',
    Math.max(120, Math.round(CFG.poll * 0.9)) + 'ms');

  var total = cellsCount(), used = [], i;
  for(i = 0; i < total; i++) if(CFG.cells[i]) used.push(i);

  /* In view mode a trailing row of empty slots is dead space, so the grid
     stops after the row holding the last cell. In customize mode every slot is
     there, because an empty one is where the next cell goes. */
  var show = total;
  if(!EDIT) show = used.length
    ? (Math.floor(used[used.length - 1] / CFG.cols) + 1) * CFG.cols : 0;

  for(i = 0; i < show; i++){
    var o = buildCell(i);
    if(o.empty && !EDIT) o.el.style.visibility = 'hidden';
    cellObjs[i] = o;
    g.appendChild(o.el);
  }

  q('emptyhint').hidden = (used.length > 0) || EDIT;
  q('colnum').textContent = CFG.cols;
  q('rownum').textContent = CFG.rows;
  q('dashnote').textContent = used.length
    ? used.length + (used.length === 1 ? ' value' : ' values') +
      ' · updating ' + (1000 / CFG.poll).toFixed(1) + ' times a second'
    : '';

  /* Rebuilding the grid leaves every cell showing "--" until the next poll,
     and in customize mode the next poll is up to two seconds away. Ask once,
     now: a structural change happens when somebody drops a cell or fills the
     grid, not on every frame, so this is one extra request per action. */
  if(EDIT && used.length) pollDash();
}

/* One poll's values. Touches nothing structural: a needle moves and one string
   changes, which is the whole update. */
function applyValues(v, f){
  Object.keys(cellObjs).forEach(function(k){
    var o = cellObjs[k], i = +k;
    if(!o || o.empty) return;

    var raw = (v && i < v.length) ? v[i] : null;
    var fresh = !!(f && f[i]);
    var c = o.cfg;

    if(raw === false){
      /* Configured, but this frame map has no such signal - which is what
         swapping SD cards looks like. Say so on the cell, rather than a dash
         that could equally mean "not arrived yet". */
      o.el.classList.add('miss');
      o.el.classList.remove('stale');
      o.val.textContent = 'unknown';
      o.val.className = 'cval big v-warn';
      o.val.style.display = '';
      if(o.unit) o.unit.textContent = 'not in this frame map';
      return;
    }
    o.el.classList.remove('miss');
    if(o.unit && c.w !== 'state') o.unit.textContent = c.unit || '';

    var num = (raw === null || raw === '') ? NaN : parseFloat(raw);
    var z = zoneOf(c, num);

    o.el.classList.toggle('stale', !fresh);
    if(c.w !== 'state'){
      o.val.textContent = isFinite(num) ? fmtVal(num, decOf(c)) : (raw ? raw : '--');
      o.val.className = 'cval' + (o.w.node ? '' : ' big') + ' v-' + z;
    }
    if(o.w.set) o.w.set(num, raw, z);
    if(c.sig) LIVE[(c.b || 1) + ':' + c.sig] = raw;
  });
}

/* ---- the health tiles, driven from either endpoint --------------------- *
 * /api/dash and /api/status carry the same counters under the same names, so
 * whichever tab is open paints these from whatever it was already fetching.  */
function paintHealth(d){
  q('conn').textContent = (d.ap ? 'Hotspot ' : 'Wi-Fi ') + d.ip;

  if(!d.sd){ setDot('d_sd','bad'); q('t_sd').textContent = 'NOT FOUND';
             q('s_sd').textContent = 'Insert a FAT32 card and restart'; }
  else if(d.sdErr){ setDot('d_sd','bad'); q('t_sd').textContent = 'WRITE ERROR';
             q('s_sd').textContent = (d.sdLost ? d.sdLost + ' KB of rows not '
               + 'recorded - ' : '') + 'card may be full or was removed'; }
  else { setDot('d_sd','ok'); q('t_sd').textContent = 'READY';
             q('s_sd').textContent = d.sdType + ', ' + (d.sdMB/1024).toFixed(1) + ' GB'; }

  /* One card per controller. `d.can` is the ARRAY of them - both /api/status
     and the dashboard poll carry the same shape, so this runs unchanged on
     either. */
  var buses = d.can || [];
  for(var bi = 0; bi < buses.length; bi++){
    var b = buses[bi], n = bi + 1;
    var dot = 'd_c' + n, big = 't_c' + n, sub = 's_c' + n, bar = 'bar_c' + n;
    if(!q(dot)) continue;

    if(!b.on){
      /* Two different reasons a controller is not here, and they need
         different messages: compiled out is a decision, no answer is a
         wiring check. Telling somebody with an unplugged module that it is
         "disabled in config.h" sends them to the wrong file. */
      setDot(dot, b.en ? 'bad' : 'warn');
      q(big).textContent = b.en ? 'NOT DETECTED' : 'OFF';
      q(sub).textContent = b.en
        ? 'No controller answered - check this module, or set CAN' + n +
          '_ENABLED 0'
        : 'Disabled in config.h - running as a single-bus logger';
      q(bar).style.width = '0%'; continue;
    }
    if(b.intStuck){
      /* The worst failure this logger has, because it is silent: frames still
         arrive, just ninety percent fewer of them. */
      setDot(dot,'bad'); q(big).textContent = 'INT NOT FIRING';
      q(sub).textContent = 'On the fallback poll - check this bus\'s INT wire';
    } else if(!b.alive){
      setDot(dot,'bad'); q(big).textContent = 'NO DATA';
      q(sub).textContent = 'Check the wiring, bit rate and this module\'s crystal';
    } else {
      setDot(dot,'ok');
      q(big).textContent = b.fps.toLocaleString() + ' /s';
      q(sub).textContent = b.load + '% load \u00b7 irq ' + b.irq.toLocaleString() +
                           '/s \u00b7 INT ' + (b.intLevel ? 'idle high' : 'asserted') +
                           (b.dbc ? '' : ' \u00b7 raw');
    }

    var L = b.alive ? b.load : 0, eb = q(bar);
    eb.style.width = Math.min(L, 100) + '%';
    eb.style.background = L < 60 ? 'var(--ok)' : (L < 80 ? 'var(--warn)' : 'var(--bad)');
  }

  /* "on either bus" is a lie on a logger with one module fitted, and it is
     the kind of lie that makes somebody go looking for hardware they never
     installed. Counted from what actually answered. */
  var liveBuses = 0;
  for(var li = 0; li < buses.length; li++) if(buses[li].on) liveBuses++;

  if(!d.lost){ setDot('d_lost','ok'); q('t_lost').textContent = 'ALL GOOD';
               q('s_lost').textContent = 'No frames lost on ' +
                 (liveBuses > 1 ? 'either bus' : 'the bus') + ' - up to ' +
                 d.risk + ' ms at risk if power is cut'; }
  else {
    /* A FLOOR, and it says so. The queue-drop half is exact - it counts frames
       - but a controller's overflow flags are sticky and say only THAT a frame
       was lost, never how many. Broken out per bus, because "which one" is the
       first thing anyone needs to know. */
    setDot('d_lost','bad');
    q('t_lost').textContent = '\u2265 ' + d.lost + ' LOST';
    var parts = [];
    if(d.qDrop) parts.push(d.qDrop + ' the writer could not keep up with (exact)');
    for(var k = 0; k < buses.length; k++){
      if(buses[k].ovfEv) parts.push('CAN' + (k+1) + ': ' + buses[k].ovfEv +
        ' controller overflow(s), each costing at least one frame and usually more');
    }
    q('s_lost').textContent = parts.length ? parts.join(' \u00b7 ')
                                           : 'Some frames could not be saved';
  }

  /* Drain time against the 200 us deadline. Shown always, not only when it has
     gone wrong: the margin is the claim, so it should be visible while it
     holds rather than appearing only once it does not. */
  if(q('t_drain')){
    var us = d.drain || 0, pct = Math.min(us / 2, 100);
    q('t_drain').textContent = us + ' \u00b5s';
    q('s_drain').textContent = 'worst drain of both controllers, deadline 200 \u00b5s' +
      (d.qPeak !== undefined ? ' \u00b7 queue peak ' + d.qPeak + '/' + d.qLen : '');
    setDot('d_drain', us < 120 ? 'ok' : (us < 200 ? 'warn' : 'bad'));
    var db = q('drainbar');
    db.style.width = pct + '%';
    db.style.background = us < 120 ? 'var(--ok)' : (us < 200 ? 'var(--warn)' : 'var(--bad)');
  }

  if(d.rec){
    setDot('d_rec','ok rec');
    q('t_rec').textContent = 'REC  ' + hms(d.elapsed);
    q('s_rec').textContent = d.file + '  -  ' + d.rows.toLocaleString() + ' rows, ' +
                             (d.kb/1024).toFixed(1) + ' MB';
    q('btn').textContent = 'STOP'; q('btn').className = 'stop';
  } else if(d.pf){
    setDot('d_rec','bad');
    q('t_rec').textContent = 'POWER LOSS';
    q('s_rec').textContent = d.file + ' was closed safely - press START for a new file';
    q('btn').textContent = 'START'; q('btn').className = 'start';
  } else {
    setDot('d_rec','warn');
    q('t_rec').textContent = 'STOPPED';
    q('s_rec').textContent = 'Nothing is being saved';
    q('btn').textContent = 'START'; q('btn').className = 'start';
  }

  /* Free heap AND the largest block, because they fail apart: the radio and
     the page both need one big allocation, and this board has refused to start
     Wi-Fi with 80 KB free because no single block was big enough. `low` is the
     worst that block has been since boot, so a squeeze that has since
     recovered still shows. */
  q('s_up').textContent = 'up ' + hms(Math.floor(d.up/1000)) + ', ' +
        Math.round(d.heap/1024) + ' KB free' +
        (d.heapMax === undefined ? '' :
           ' \u00b7 block ' + Math.round(d.heapMax/1024) + ' KB' +
           ' \u00b7 low ' + Math.round(d.heapLow/1024) + ' KB') +
        (d.web === undefined ? '' : ' \u00b7 web ' + d.web + '/s');
  q('foot').textContent = d.fw;
}

/* ---- polling ----------------------------------------------------------- */
function pollDash(){
  return fetch('/api/dash').then(function(r){ return r.json(); }).then(function(d){
    fails = 0;
    if(GEN !== 0 && d.gen !== GEN && !EDIT){
      GEN = d.gen;
      loadCfg();            /* somebody saved from another browser */
      return;
    }
    GEN = d.gen;
    if(d.max) MAXCELLS = d.max;
    if(d.poll && d.poll !== CFG.poll && !EDIT){ CFG.poll = d.poll; startPolls(); }

    paintHealth(d);
    applyValues(d.v, d.f);

    ARMED = !!d.arm;
    ARMLEFT = d.armLeft || 0;
    CYC = d.cyc || 0;
    CANTX = d.canTx;
    paintArm();
    if(TAB === 'send') paintSendState();

    (d.tx || []).forEach(function(o){
      if(o.t <= lastTicket) return;
      lastTicket = o.t;
      var ok = (o.s === 0);
      toast(ok ? 'Sent' : 'Not sent',
            o.id + ' — ' + o.m +
            (o.c ? ' (the value was clamped to what the signal can hold)' : '') +
            (!ok && o.tec ? ' [TEC ' + (o.tec > 0 ? '+' : '') + o.tec + ']' : ''),
            ok ? 'ok' : 'bad');
    });
  }).catch(function(){
    if(++fails > 2) q('conn').textContent = 'connection lost';
  });
}

function paintIds(list){
  var body = q('ids'), html = '', i;
  for(i = 0; i < list.length; i++){
    var e2 = list[i];
    html += '<tr class="' + (e2.k ? '' : 'un') + '"><td class="mono">' + esc(e2.id) +
            '</td><td class="mono">' + esc(e2.d) + '</td><td>' +
            e2.n.toLocaleString() + '</td><td>' + e2.r + '/s</td><td>' +
            (e2.k ? 'yes' : 'raw') + '</td></tr>';
  }
  body.innerHTML = html || '<tr><td colspan="5">nothing received yet</td></tr>';
}

function paintSigs(list, mapped, bus){
  var body = q('sigs'), html = '', i;
  for(i = 0; i < list.length; i++){
    var e2 = list[i];
    /* Keyed by bus as well as by name. Two buses routinely carry a message of
       the same name, and a shared key would have one bus's value quietly
       overwriting the other's on every poll - including on the dashboard. */
    LIVE[bus + ':' + e2.m + '.' + e2.s] = e2.v;
    html += '<tr><td class="c1 ell" title="' + esc(e2.m) + '">' + esc(e2.m) +
            '</td><td class="c2 ell" title="' + esc(e2.s) + '">' + esc(e2.s) +
            '</td><td class="c3 num mono">' + esc(e2.v) +
            '</td><td class="c4">' + esc(e2.u) + '</td></tr>';
  }
  if(!html){
    html = '<tr><td colspan="4">' + (mapped
      ? 'no mapped frame has arrived yet'
      : 'no frame map on the card - see the raw frames below') + '</td></tr>';
  }
  body.innerHTML = html;
}

function pollStatus(){
  return fetch('/api/status').then(function(r){ return r.json(); }).then(function(d){
    fails = 0;
    paintHealth(d);

    /* Every bus's live values are absorbed on every poll, whichever one the
       tables are showing: a dashboard cell reads from LIVE, and a cell bound to
       CAN 2 must keep updating while the operator is looking at CAN 1. */
    var all = d.can || [];
    for(var i = 0; i < all.length; i++) paintLive(all[i].b, all[i].sig || []);

    var b = all[BUS - 1];
    if(!b){ return; }

    paintSigs(b.sig || [], b.dbc, b.b);
    q('s_sigs').textContent = b.dbc
      ? ('CAN ' + b.b + ' frame map: ' + b.dbcMsg + ' messages, ' + b.dbcSig +
         ' signals' + (b.sigMore ? '  -  showing the first ' + b.sig.length : ''))
      : ('no frame map for CAN ' + b.b +
         ' - upload one to decode this bus in real time');

    paintIds(b.ids || []);
    q('s_ids').textContent = b.idMore
      ? 'more identifiers are on CAN ' + b.b + ' than the table tracks - all of ' +
        'them are still recorded'
      : 'every identifier seen on CAN ' + b.b + ' since the recording started';

    q('s_buspick').textContent = all.map(function(x){
      /* Where the bit rate came from, when it was not simply configured: a
         rate the bus confirmed and a rate nothing confirmed are worth
         different amounts of trust, and only the second one is a reason to go
         and look at CANn_BITRATE_KBPS. */
      var how = !x.auto ? '' : (x.autoOk ? ' detected' : ' assumed');
      return 'CAN ' + x.b + ': ' + (x.on ? (x.kbps + ' kbit/s' + how + ', ' +
             (x.alive ? x.fps.toLocaleString() + ' frames/s' : 'quiet'))
             : (x.en ? 'not detected' : 'off'));
    }).join('   \u00b7   ');
  }).catch(function(){ if(++fails > 2) q('conn').textContent = 'connection lost'; });
}

/* Fills LIVE for one bus without touching the DOM. Split out from paintSigs so
   the values of the bus that is NOT on screen still reach the dashboard. */
function paintLive(bus, list){
  for(var i = 0; i < list.length; i++){
    LIVE[bus + ':' + list[i].m + '.' + list[i].s] = list[i].v;
  }
}

function pollLog(){
  return fetch('/api/log?since=' + seq).then(function(r){ return r.json(); })
    .then(function(d){
      seq = d.seq;
      if(!d.lines.length) return;
      var t = q('term');
      var atBottom = t.scrollHeight - t.scrollTop - t.clientHeight < 40;
      for(var i = 0; i < d.lines.length; i++){
        var s = d.lines[i], div = el('div');
        var m = s.match(/^\[[^\]]*\]\s(\w)\s/);
        div.className = m ? m[1] : '';
        div.textContent = s;
        t.appendChild(div);
      }
      while(t.childNodes.length > 300) t.removeChild(t.firstChild);
      if(atBottom) t.scrollTop = t.scrollHeight;
    }).catch(function(){});
}

/* ---- saving ------------------------------------------------------------ */
/* An edit reaches the logger by itself, shortly after you stop making it.
 *
 * This is not only about not losing work. The dashboard's VALUES come from the
 * logger, which renders them from the layout it holds - handleDash() walks
 * g_dash, and nothing in this page. So a cell the logger has not been told
 * about shows nothing at all, and an editing session that never reaches it is
 * one where half the screen stays blank. There was a Save button here for one
 * release and that was exactly its effect: the dashboard only came alive once
 * you found the button.
 *
 * The delay is what keeps it cheap. Dragging a cell across the grid is one
 * write when you let go, not one per frame. */
var saveTimer = null;
var cfgDirty = false;
function markDirty(){
  cfgDirty = true;
  clearTimeout(saveTimer);
  saveTimer = setTimeout(saveCfg, 1200);
}
/* A change still waiting for its save, sent now. Anything that acts on the
   layout the server holds - trimming a frame map, Preview, Export - goes
   through this first: a trim that ran against the layout from a second ago
   would drop the message behind the cell or setpoint just added. */
function flushCfg(){
  return cfgDirty ? saveCfg() : Promise.resolve();
}
function saveCfg(){
  clearTimeout(saveTimer);
  cfgDirty = false;
  return fetch('/api/dash/cfg', {method:'POST', body:dumpCfg()})
    .then(function(r){ return r.json(); })
    .then(function(d){
      GEN = d.gen;
      if(!d.ok) toast('Not saved', 'The logger could not store the layout', 'bad');
      else if(d.missing) toast('Saved',
        d.missing + ' cell(s) name a signal this frame map does not have', 'bad');
    })
    .catch(function(){ toast('Not saved', 'The logger did not answer', 'bad'); });
}
function loadCfg(){
  return fetch('/api/dash/cfg').then(function(r){ return r.text(); })
    .then(function(t){
      CFG = parseCfg(t);
      renderRoleBtn();
      renderGrid();
      renderSend();
      startPolls();
    });
}
function loadDbc(bus, force){
  bus = bus || EDBUS;
  EDBUS = bus;
  if(DBCS[bus - 1] && !force){ DBC = DBCS[bus - 1]; return Promise.resolve(); }
  return fetch('/api/signals?bus=' + bus).then(function(r){ return r.json(); })
    .then(function(d){ DBCS[bus - 1] = d; DBC = d; });
}

/* Point the editor at another bus and redraw whatever it is showing. Used by
   the bus selector inside the cell and setpoint dialogs. */
function useDbc(bus, after){
  return loadDbc(bus, false).then(function(){ if(after) after(); });
}

/* ---- customize mode ---------------------------------------------------- */
function setEdit(on){
  EDIT = on;
  document.body.classList.toggle('edit', on);
  q('editbar').hidden = !on;
  q('viewbar').hidden = on;
  if(on) loadDbc(BUS);
  renderGrid();
  startPolls();
  if(!on) saveCfg();          /* leaving the editor is a decision */
}
function step(which, by){
  var lim = which === 'cols' ? 6 : 8;
  var v = Math.max(1, Math.min(lim, CFG[which] + by));
  if(v === CFG[which]) return;
  CFG[which] = v;
  renderGrid();
  markDirty();
}

/* Drag and drop on pointer events rather than the HTML5 drag API, which does
   not fire on touch at all - and this page is used on a phone at least as often
   as on a laptop. */
var drag = null;
function ghostTo(e){
  if(!drag) return;
  drag.ghost.style.left = e.clientX + 'px';
  drag.ghost.style.top  = e.clientY + 'px';
}
q('grid').addEventListener('pointerdown', function(e){
  if(!EDIT || e.button > 0) return;
  var cell = e.target.closest ? e.target.closest('.cell.slot') : null;
  if(!cell) return;

  var act = e.target.closest('[data-act]');
  if(act){
    var s = +cell.dataset.slot;
    if(act.dataset.act === 'edit') openEditor(s);
    else { removeCell(s); renderGrid(); markDirty(); }
    return;
  }

  var slot = +cell.dataset.slot;
  if(!CFG.cells[slot]){ openEditor(slot); return; }

  e.preventDefault();
  var r = cell.getBoundingClientRect();
  var ghost = cell.cloneNode(true);
  ghost.id = 'ghost';
  ghost.className = 'cell';
  ghost.style.width = r.width + 'px';
  ghost.style.height = r.height + 'px';
  document.body.appendChild(ghost);
  cell.classList.add('lift');

  drag = {from:slot, cell:cell, ghost:ghost, over:null, moved:false};
  ghostTo(e);
  try { cell.setPointerCapture(e.pointerId); } catch(err){}
});
document.addEventListener('pointermove', function(e){
  if(!drag) return;
  drag.moved = true;
  ghostTo(e);
  var t = document.elementFromPoint(e.clientX, e.clientY);
  var over = (t && t.closest) ? t.closest('.cell.slot') : null;
  if(drag.over && drag.over !== over) drag.over.classList.remove('over');
  if(over && over !== drag.cell){ over.classList.add('over'); drag.over = over; }
  else drag.over = null;
});
document.addEventListener('pointerup', function(e){
  if(!drag) return;
  var dg = drag; drag = null;
  dg.ghost.remove();
  dg.cell.classList.remove('lift');

  if(dg.over){
    dg.over.classList.remove('over');
    var to = +dg.over.dataset.slot;
    /* A swap, not an insert: whatever was there moves to where this came from,
       so nothing is ever silently overwritten. */
    var a = CFG.cells[dg.from], b = CFG.cells[to];
    if(b) CFG.cells[dg.from] = b; else delete CFG.cells[dg.from];
    CFG.cells[to] = a;
    renderGrid();
    markDirty();
  } else if(!dg.moved){
    openEditor(dg.from);
  }
});

/* Lay the bus out automatically - the fastest route from a fresh logger to a
   dashboard worth looking at, and what makes the whole feature discoverable. */
/* Two ways to fill the grid, because there are two situations.

   'map'  - at a desk, before going out, with a frame map loaded and no bus
            anywhere. Lays out what the file DESCRIBES, in file order, as far
            as the grid goes. Nothing has to be connected for this to work.
   'bus'  - standing at the machine with traffic running. Same list, but the
            signals actually arriving are placed first, and the ones that are
            only in the file are capped, because a grid full of cells that will
            never update is worse than a small one where everything moves.

   Both end at the same place: a starting point you then drag around. */
function fillCells(source){
  var jobs = [loadDbc()];
  if(source === 'bus'){
    jobs.push(fetch('/api/status').then(function(r){ return r.json(); }));
  }
  return Promise.all(jobs).then(function(res){
    var live = {};
    if(source === 'bus'){
      /* Out of THIS bus's element of the status payload. There is no top-level
         "sig" any more - the live-signal list moved inside can[] when the
         second bus arrived, and reading the old place silently produced an
         empty set: "Fill from bus" then ordered by nothing and capped nothing,
         which is exactly the button's whole reason to exist. */
      var me = (res[1].can || []).filter(function(b){ return b.b === EDBUS; })[0];
      ((me && me.sig) || []).forEach(function(s){ live[s.m + '.' + s.s] = 1; });
    }

    if(!DBC.m.length){
      toast('No frame map', 'Put a .dbc on the card as /frames.dbc, or add '
            + 'cells one at a time', 'bad');
      return;
    }

    var taken = {};
    Object.keys(CFG.cells).forEach(function(k){ taken[CFG.cells[k].sig] = 1; });

    var pick = [], skipped = 0;
    /* The role of the bus whose map this is - DBC always belongs to EDBUS -
       because a role is per bus and filling CAN2's signals against CAN1's
       answer would split the wrong list. */
    var role = roleOf(EDBUS);
    DBC.m.forEach(function(m){
      /* A message this logger is the one transmitting is a command, not a
         reading: its "value" is whatever we last wrote. */
      if(role && m.tx === role){ skipped++; return; }
      m.s.forEach(function(s){
        var ref = m.n + '.' + s.n;
        if(!taken[ref]) pick.push({ref:ref, s:s, live:live[ref] ? 1 : 0});
      });
    });
    if(source === 'bus'){
      /* stable: equal keys keep frame-map order, so the result is repeatable */
      pick.sort(function(a, b){ return b.live - a.live; });
    }

    var room  = Math.min(MAXCELLS, CFG.cols * 8);
    var slot = 0, added = 0, seen = 0;
    pick.forEach(function(p){
      while(CFG.cells[slot]) slot++;
      if(slot >= room) return;
      if(source === 'bus' && p.live) seen++;
      if(source === 'bus' && added >= 12 && !p.live) return;
      CFG.cells[slot] = cellFromSignal(p.ref, p.s);
      added++;
    });

    var keys = Object.keys(CFG.cells).map(Number);
    if(keys.length){
      var need = Math.ceil((Math.max.apply(null, keys) + 1) / CFG.cols);
      if(need > CFG.rows) CFG.rows = Math.min(8, need);
    }
    renderGrid();
    markDirty();

    if(!added){
      toast('Nothing to add', 'Every signal in the frame map is already on the '
            + 'dashboard', 'ok');
    } else if(source === 'bus'){
      toast('Filled from the bus', added + ' cell(s) added, ' + seen
            + ' of them arriving right now — drag them around, or tap one to '
            + 'change how it is drawn', 'ok');
    } else {
      toast('Filled from the frame map', added + ' cell(s) added'
            + (skipped ? ', ' + skipped + ' message(s) ' + role
                       + ' sends left for the Send tab' : '')
            + ' — drag them around, or tap one to change how it is drawn', 'ok');
    }
  });
}

/* What a signal should look like, before anyone has said otherwise. */
function guessWidget(ref, s){
  var n = sigName(ref).toLowerCase(), u = (s.u || '').toLowerCase();
  if(s.v && s.v.length) return 'state';
  if(s.b === 1) return 'state';
  if(/temp|coolant|therm/.test(n) || /^(degc|degf|c|f|k|°c|°f)$/.test(u)) return 'thermo';
  if(/level|tank|fuel|soc|charge|volume/.test(n)) return 'level';
  if(/head|yaw|course|bearing|azimuth|crank/.test(n)) return 'compass';
  if(/angle|steer|tilt|roll|pitch|articul|slope/.test(n)) return 'angle';
  if(/press/.test(n) || /^(bar|psi|kpa|mpa|pa)$/.test(u)) return 'arc';
  if(/speed|rpm|flow|revs|velocity/.test(n) ||
     /^(km\/h|kph|mph|m\/s|rpm|l\/min|l\/h|min-1)$/.test(u)) return 'gauge';
  if(u === '%' || u === 'pct') return 'bar';
  if(/^(deg|°|rad)$/.test(u)) return (s.lo < 0 && s.r) ? 'angle' : 'compass';
  return 'number';
}
/* SteeringAngle -> "Steering angle". The title has to be WRITTEN DOWN rather
   than left empty and derived at draw time: an empty label meant reopening a
   cell showed a blank Title box under a cell that plainly had a title. */
function prettyName(ref){
  var n = sigName(ref).replace(/[_.]+/g, ' ')
                      .replace(/([a-z0-9])([A-Z])/g, '$1 $2')
                      .replace(/\s+/g, ' ').trim();
  return n ? n.charAt(0).toUpperCase() + n.slice(1).toLowerCase() : n;
}
function cellFromSignal(ref, s){
  var lo = s.r ? s.lo : s.blo, hi = s.r ? s.hi : s.bhi;
  /* A 32-bit counter's true limits are in the billions, which draws a gauge
     that never moves. Anything that wide is shown as a number instead. */
  if(!isFinite(lo) || !isFinite(hi) || hi - lo > 1e7){ lo = 0; hi = 100; }
  return {
    w: guessWidget(ref, s), sig: ref, label: prettyName(ref), unit: s.u || '',
    lo: lo, hi: hi, dec: isFinite(s.d) ? Math.min(s.d, 3) : null,
    warn: null, crit: null, lowbad: 0
  };
}
</script>
)HTML";

/* ==========================================================================
 *  PART 5 - the cell editor, the transmit view, and start-up.
 * ======================================================================== */
static const char PAGE_5[] PROGMEM = R"HTML(<script>
"use strict";
var edSlot = -1, edCfg = null, edPicked = false;

/* Small glyphs for the style picker. Drawn separately from the real widgets
   rather than rendered small: a gauge at 60 by 38 pixels is a smudge with
   unreadable tick labels, and the point of a picker is recognisability. */
function miniIcon(id){
  var g = sv('svg', {viewBox:'0 0 60 38'});
  function p(path, o){
    var a = {d:path, fill:'none', stroke:'currentColor', 'stroke-width':3,
             'stroke-linecap':'round'}, k;
    if(o) for(k in o) a[k] = o[k];
    g.appendChild(sv('path', a));
  }
  function r(x, y, w, h, o){
    var a = {x:x, y:y, width:w, height:h, rx:Math.min(w,h)/2,
             fill:'currentColor'}, k;
    if(o) for(k in o) a[k] = o[k];
    g.appendChild(sv('rect', a));
  }
  switch(id){
    case 'gauge':
      p('M12 30 A18 18 0 1 1 48 30', {opacity:.35});
      p('M12 30 A18 18 0 0 1 22 14', {stroke:'var(--acc)'});
      p('M30 30 L38 18', {'stroke-width':2.4}); break;
    case 'arc':
      p('M10 28 A20 20 0 0 1 50 28', {opacity:.35});
      p('M10 28 A20 20 0 0 1 26 9', {stroke:'var(--acc)'});
      p('M30 28 L30 12', {'stroke-width':2.4}); break;
    case 'angle':
      p('M10 28 A20 20 0 0 1 50 28', {opacity:.35});
      p('M30 8 A20 20 0 0 1 46 17', {stroke:'var(--acc)'});
      p('M30 28 L41 14', {'stroke-width':2.4});
      p('M30 8 L30 13', {'stroke-width':2, opacity:.8}); break;
    case 'compass':
      g.appendChild(sv('circle', {cx:30, cy:19, r:15, fill:'none',
        stroke:'currentColor', 'stroke-width':3, opacity:.35}));
      p('M30 19 L38 8', {stroke:'var(--acc)'});
      p('M30 19 L25 27', {'stroke-width':2.4, opacity:.6}); break;
    case 'bar':
      r(8, 14, 44, 11, {opacity:.45});
      r(8, 14, 27, 11, {fill:'var(--acc)'}); break;
    case 'level':
      r(22, 5, 16, 29, {opacity:.45});
      g.appendChild(sv('rect', {x:22, y:19, width:16, height:15, rx:5,
        fill:'var(--acc)'})); break;
    case 'thermo':
      r(26, 4, 8, 20, {opacity:.35});
      g.appendChild(sv('rect', {x:27.5, y:13, width:5, height:12,
        fill:'var(--acc)'}));
      g.appendChild(sv('circle', {cx:30, cy:28, r:7, fill:'var(--acc)'})); break;
    case 'number': {
      var t = sv('text', {x:30, y:26, 'text-anchor':'middle', 'font-size':19,
        'font-weight':700, fill:'currentColor'});
      t.textContent = '42'; g.appendChild(t); break; }
    case 'spark':
      p('M8 26 L17 18 L24 22 L32 10 L40 16 L52 7',
        {stroke:'var(--acc)', 'stroke-width':2.6}); break;
    case 'state':
      r(11, 11, 38, 17, {fill:'var(--acc)', opacity:.75}); break;
  }
  return g;
}

function renderWidgetPicker(){
  var box = q('wpick');
  box.innerHTML = '';
  WIDGETS.forEach(function(w){
    var b = el('button');
    b.type = 'button';
    b.title = w.name + ' — ' + w.hint;
    b.className = (edCfg.w === w.id) ? 'on' : '';
    b.appendChild(miniIcon(w.id));
    b.appendChild(el('span', null, w.name));
    b.onclick = function(){
      edCfg.w = w.id;
      edPicked = true;
      renderWidgetPicker();
      applyFieldVisibility();
      refreshPreview();
    };
    box.appendChild(b);
  });
}

function findSig(ref){
  var out = null;
  DBC.m.forEach(function(m){
    m.s.forEach(function(s){ if(m.n + '.' + s.n === ref) out = s; });
  });
  return out;
}

function renderSignalList(filter){
  var box = q('slist');
  box.innerHTML = '';
  var f = (filter || '').toLowerCase(), shown = 0;

  DBC.m.forEach(function(m){
    m.s.forEach(function(s){
      var ref = m.n + '.' + s.n;
      if(f && ref.toLowerCase().indexOf(f) < 0 &&
         (s.u || '').toLowerCase().indexOf(f) < 0) return;
      if(shown >= 300) return;
      shown++;

      var row = el('div', 'row' + (edCfg.sig === ref ? ' on' : ''));
      var nm = el('div', 'sn', s.n);
      nm.title = ref;
      row.appendChild(nm);
      row.appendChild(el('div', 'sm', m.n + (s.u ? ' · ' + s.u : '')));
      var lk = edBus() + ':' + ref;
      row.appendChild(el('div', 'sv',
        LIVE[lk] !== undefined && LIVE[lk] !== '' ? LIVE[lk] : ''));
      row.onclick = function(){ chooseSignal(ref, s); };
      if(edCfg.sig === ref) box._sel = row;
      box.appendChild(row);
    });
  });

  /* The chosen row carries a highlight, but in a list of three hundred signals
     a highlight nobody can see reads as "nothing is selected". */
  if(box._sel){
    box.scrollTop = Math.max(0, box._sel.offsetTop - box.clientHeight / 2
                                + box._sel.offsetHeight / 2);
    box._sel = null;
  }

  if(!shown){
    box.appendChild(el('div', 'none', DBC.loaded
      ? 'No signal matches that.'
      : 'There is no frame map on the card, so there are no named signals to '
        + 'choose from. Add a DBC file and restart the logger.'));
  }
}

/* Picking a signal fills in everything the frame map already knows and
   suggests a shape - the difference between "choose a signal" and "answer six
   questions about a signal". Anything changed by hand is left alone. */
function chooseSignal(ref, s){
  edCfg.sig = ref;
  if(!edPicked) edCfg.w = guessWidget(ref, s);

  var lo = s.r ? s.lo : s.blo, hi = s.r ? s.hi : s.bhi;
  if(!isFinite(lo) || !isFinite(hi) || hi - lo > 1e7){ lo = 0; hi = 100; }
  edCfg.lo = lo;
  edCfg.hi = hi;
  edCfg.unit = s.u || '';
  edCfg.dec = isFinite(s.d) ? Math.min(s.d, 3) : null;
  if(!edCfg.label) edCfg.label = prettyName(ref);

  fieldsFromCfg();
  renderWidgetPicker();
  renderSignalList(q('sfilter').value);
  refreshPreview();
}

/* Which of the detail fields the chosen drawing actually reads. A state pill
   takes its text and its colour from the frame map's own VAL_ names - it never
   looks at a minimum, a maximum, a decimal count or a threshold - so offering
   those is offering six answers that change nothing. */
var WFIELDS = {
  /*          unit  dec   lo/hi  thresholds */
  state:    [ 0,    0,    0,     0 ],
  number:   [ 1,    1,    0,     1 ],
  compass:  [ 1,    1,    0,     1 ],
  spark:    [ 1,    1,    1,     1 ]
};
function applyFieldVisibility(){
  var f = WFIELDS[edCfg.w] || [1, 1, 1, 1];
  q('fw_unit').hidden   = !f[0];
  q('fw_dec').hidden    = !f[1];
  q('fw_lo').hidden     = !f[2];
  q('fw_hi').hidden     = !f[2];
  q('h_thresh').hidden  = !f[3];
  q('fw_thresh').hidden = !f[3];
  q('fw_lowbad').hidden = !f[3];

  var note = q('statenote');
  if(edCfg.w !== 'state'){ note.hidden = true; return; }
  var sg = findSig(edCfg.sig);
  note.hidden = false;
  note.innerHTML = (sg && sg.v && sg.v.length)
    ? 'The frame map names these states: <b>' + sg.v.join('</b> · <b>')
      + '</b>. They are shown as written, and coloured by what they say &mdash; '
      + 'anything reading fault, alarm or error goes red, ok or ready goes '
      + 'green. There is nothing to scale.'
    : 'This signal has no <code>VAL_</code> names in the frame map, so the '
      + 'number itself is shown. Adding a <code>VAL_</code> line to the '
      + '<code>.dbc</code> is what turns it into words.';
}

function fieldsFromCfg(){
  applyFieldVisibility();
  q('f_label').value = edCfg.label || '';
  q('f_unit').value  = edCfg.unit || '';
  q('f_dec').value   = (edCfg.dec === null || edCfg.dec === undefined) ? '' : edCfg.dec;
  q('f_lo').value    = edCfg.lo;
  q('f_hi').value    = edCfg.hi;
  q('f_warn').value  = (edCfg.warn === null || edCfg.warn === undefined) ? '' : edCfg.warn;
  q('f_crit').value  = (edCfg.crit === null || edCfg.crit === undefined) ? '' : edCfg.crit;
  q('f_lowbad').checked = !!edCfg.lowbad;
}
function cfgFromFields(){
  function opt(id){
    var v = q(id).value.trim();
    return v === '' ? null : parseFloat(v);
  }
  edCfg.label = q('f_label').value;
  edCfg.unit  = q('f_unit').value;
  var dv = q('f_dec').value.trim();
  edCfg.dec   = dv === '' ? null : Math.max(0, Math.min(6, parseInt(dv, 10) || 0));
  edCfg.lo    = parseFloat(q('f_lo').value) || 0;
  edCfg.hi    = parseFloat(q('f_hi').value);
  if(!isFinite(edCfg.hi)) edCfg.hi = edCfg.lo + 100;
  edCfg.warn   = opt('f_warn');
  edCfg.crit   = opt('f_crit');
  edCfg.lowbad = q('f_lowbad').checked ? 1 : 0;
}

/* The preview is the real widget fed the real value. Seeing the needle sit
   where it will sit is worth more than any description of a gauge. */
function refreshPreview(){
  var host = q('prevcell');
  host.innerHTML = '';
  host.className = 'cell';

  host.appendChild(el('div', 'cname', cellTitle(edCfg) || 'no signal chosen'));
  var w = makeWidget(edCfg);
  var gfx = el('div', 'gfx');
  if(w.node) gfx.appendChild(w.node);
  host.appendChild(gfx);

  var raw = LIVE[(edCfg.b || 1) + ':' + edCfg.sig];
  var v = (raw === undefined || raw === '') ? NaN : parseFloat(raw);
  /* With nothing live, park the needle where it can be seen rather than hard
     against the stop. */
  if(!isFinite(v) && edCfg.w !== 'state') v = edCfg.lo + (edCfg.hi - edCfg.lo) * 0.62;
  var z = zoneOf(edCfg, v);

  if(edCfg.w !== 'state'){
    host.appendChild(el('div', 'cval' + (w.node ? '' : ' big') + ' v-' + z,
                        fmtVal(v, decOf(edCfg))));
    host.appendChild(el('div', 'cunit', edCfg.unit || ''));
  }
  if(w.set) w.set(v, (raw === undefined ? String(Math.round(v)) : raw), z);
}

function openEditor(slot){
  var have = CFG.cells[slot];
  /* An existing cell opens on ITS bus; a new one opens on whichever bus the
     operator was last looking at, which is almost always the one they mean. */
  var bus = have ? (have.b || 1) : BUS;

  loadDbc(bus).then(function(){
    edSlot = slot;
    edPicked = !!have;
    edCfg = have ? JSON.parse(JSON.stringify(have))
                 : {w:'number', sig:'', b:bus, label:'', unit:'', lo:0, hi:100,
                    dec:null, warn:null, crit:null, lowbad:0};
    if(!edCfg.b) edCfg.b = bus;

    q('sheettitle').textContent = have ? 'Edit this cell' : 'Add a value';
    q('e_del').style.display = have ? '' : 'none';
    q('sfilter').value = '';
    renderBusPicker();
    renderSignalList('');
    renderWidgetPicker();
    fieldsFromCfg();
    refreshPreview();
    q('sheet').classList.add('on');
  });
}

/* Which bus this cell reads from. Offered as a pair of buttons above the
   signal list rather than buried in the fields, because changing it changes
   what the list below can even offer - and a signal chosen from the wrong
   bus's map is a cell that will never show a value. */
function renderBusPicker(){
  var box = q('ebus');
  if(!box) return;
  box.innerHTML = '';
  for(var i = 1; i <= NBUS; i++){
    (function(n){
      var b = el('button', 'bussel' + (edCfg.b === n ? ' on' : ''), 'CAN ' + n);
      b.onclick = function(){
        if(edCfg.b === n) return;
        edCfg.b = n;
        /* The old signal belonged to the old map. Clearing it is the honest
           move: silently keeping a reference this bus cannot resolve would
           produce a cell that looks configured and never updates. */
        edCfg.sig = '';
        edPicked = false;
        useDbc(n, function(){
          renderBusPicker();
          q('sfilter').value = '';
          renderSignalList('');
          fieldsFromCfg();
          refreshPreview();
        });
      };
      box.appendChild(b);
    })(i);
  }
}
function closeEditor(){ q('sheet').classList.remove('on'); }

/* ==========================================================================
 *  Transmit
 * ======================================================================== */
/* "620:620 mm|690:690 mm" -> [{v:620, l:'620 mm'}, ...]. Written by whoever set
   the value up; the logger only stores the string. */
function parseChoices(str){
  return String(str || '').split('|').filter(Boolean).map(function(p){
    var i = p.indexOf(':');
    var v = parseFloat(i < 0 ? p : p.slice(0, i));
    return {v: isFinite(v) ? v : 0, l: (i < 0 ? p : p.slice(i + 1)) || String(v)};
  });
}
function dumpChoices(list){
  return list.map(function(c){ return trimNum(c.v) + ':' + c.l; }).join('|');
}

function paintArm(){
  var card = q('armcard');
  card.classList.toggle('on', ARMED);
  q('armstate').textContent = ARMED ? 'ARMED' : 'NOT ARMED';
  q('armbtn').textContent = ARMED ? 'DISARM' : 'ARM TRANSMIT';
  q('armsub').textContent = ARMED
    ? 'Disarms itself in ' + hms(ARMLEFT) + ' unless something is sent'
    : (CANTX ? 'Every Send button is disabled until you arm'
             : 'This build is listen-only — it cannot write to the bus at all');
  q('armfill').style.width =
    Math.max(0, Math.min(100, (ARMLEFT / 300) * 100)).toFixed(1) + '%';

  /* The pinned copy says the same thing in less room. */
  var st = q('armstick');
  st.classList.toggle('live', ARMED);
  q('stickstate').textContent = ARMED ? 'ARMED' : 'NOT ARMED';
  q('stickbtn').textContent   = ARMED ? 'DISARM' : 'ARM TRANSMIT';
  q('sticksub').textContent   = ARMED ? 'disarms in ' + hms(ARMLEFT) : '';
  if(TAB !== 'send') st.classList.remove('on');
}

function txRange(t){
  var dp = (t.dec === null || t.dec === undefined) ? 2 : t.dec;
  if(t.raw) return t.id + ' · ' + (t.data || 'no bytes');
  var s = sigName(t.sig);
  if(t.style === 'choice' || t.style === 'toggle' || t.style === 'enum') return s;
  return s + ' · ' + t.lo.toFixed(dp) + ' to ' + t.hi.toFixed(dp) +
         (t.unit ? ' ' + t.unit : '');
}

/* The input a value is picked with. This is the part worth getting right: a
   tyre size is not a number somebody should be typing next to a running
   machine, it is one of the four sizes the fleet uses. */
/* What is currently in each Send input, kept across re-draws.
 *
 * The Send tab is rebuilt whenever anything about the logger changes - arming,
 * a poll, a frame arriving - and every rebuild used to put the inputs back to
 * the values they were set up with, throwing away whatever had been typed. It
 * also meant that after sending a frame the boxes forgot what had just gone
 * out, which for a multiplexed frame is the one thing worth remembering: the
 * whole frame is written every time, so the values you did not touch are as
 * much a part of the command as the one you did.
 *
 * So a value that has been typed or sent stays put. It is kept in the page and
 * nowhere else: reloading gives a clean slate, and so does the Reset on each
 * frame. Nothing is written to the logger by remembering it. */
var TXVAL = {};

function txCur(t, i){
  var v = TXVAL[i];
  return (v === undefined || !isFinite(v)) ? t.preset : v;
}
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
