mhmmdbdrhmd/can-logger-esp32/(commit log)

2026-08-01 Initial commit: ESP32 + MCP2515 CAN logger with DBC-driven decoding
    An ESP32 bus logger that captures every CAN frame, decodes it against a DBC
    file on the SD card, and writes normalised CSV, with a live web dashboard.
    Nothing bus-specific is compiled in. Identifiers, signal layouts, scaling
    factors, units and enum labels all come from /frames.dbc on the card, so the
    same binary logs any bus. With no DBC present every frame is still recorded,
    as raw payload bytes - an unmapped bus is captured in full and can be decoded
    offline later.
    Receive path, which is the part worth preserving:
    - the CAN interrupt does only bounded work - timestamp the frame with
    esp_timer_get_time() and unbloc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
    [config.txt]
2026-08-02 Add wiring diagram
    Generated by docs/make_wiring.py rather than drawn by hand: every peer pin row is
    placed at the same y as the ESP32 pin it connects to, so all wires are straight
    horizontal lines with no crossings. Pin labels sit inside their own board, leaving
    the gaps free for wires, which is what stops text and traces overlapping.
    Colour-coded by net, with the CAN stub, termination note and the two mistakes that
    cost the most time -- wrong crystal value and exFAT cards -- called out.
    [make_wiring.py]
2026-08-02 Scope the host type-check to portable sources; add an ArduinoOTA shim
    app.cpp is the ESP32 application layer -- FreeRTOS task notifications, esp_timer,
    GPIO interrupts -- so host-compiling it would mean shimming half of ESP-IDF for no
    gain: the PlatformIO job already builds it for the real target. The step now covers
    the portable library sources, where a host compiler catches what the IDE would not.
    Adds a minimal ArduinoOTA host stub for the same reason the other shims exist.
2026-08-20 Make the receive path observable, and open the bus only when it is watched
    Three things could go wrong on the receive side without leaving a trace, and
    the dashboard would still look perfectly healthy while the logger quietly
    recorded a fraction of the traffic.
    The interrupt could wedge. The MCP2515's INT pin is level active-low: it stays
    asserted until every flag enabled in CANINTE is clear, and ERRIF/MERRF are
    sticky. One receive overflow was enough to latch a flag, after which INT never
    rose, so a FALLING-edge interrupt never fired again. Reception silently fell
    back to the 20 ms poll, which caps at ~100 frames/s. clearErrorInterrupts() now
    runs on every service pass, bit-modifying rathe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
    [app.cpp, capture_screenshots.py, decode.cpp, decode.h, mcp2515.cpp, mcp2515.h, preview_dashboard.py]
2026-08-20 Mount the SD card at a slower clock instead of reporting no card
    SD.begin() returns the same false for "there is no card" and "this wiring
    will not carry 20 MHz". A client lost an afternoon to that: the card was
    fine, the wiring was fine at 4 MHz, and the logger just said the slot was
    empty. Walk 20 -> 10 -> 4 -> 1 MHz and log which speed took, so a card
    running slow is visible rather than mysterious.
    Two power notes that caused the same confusion, now in the docs and the
    pin map: micro-SD breakout boards almost all carry their own 3V3
    regulator and want 5V on VIN - on 3V3 they brown out under write current
    and look exactly like an empty slot. The SPI lines stay 3V3 either way.
    Also releas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
    [config.h, make_wiring.py, recorder.cpp]
2026-08-27 Add a customisable dashboard and a transmit path, and size the frame map to the file
    Two features and three defects, developed together because they share the
    config file, the web page and the frame-map tables.
    FEATURES
    Dashboard: a grid of gauges the operator lays out themselves, from 1x1 to 6x8.
    Ten ways to draw a value - dial, half dial, centre-zero angle, compass, bar,
    tank, thermometer, number, trend, state pill - chosen automatically from a
    signal's unit and name and overridable per cell. Drag to rearrange (pointer
    events, so a finger works), optional amber/red thresholds, and a "low values
    are the bad ones" switch for a level that must not drop. Fill from frame map
    lays out everythi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
    [dash.cfg]
2026-08-27 Ship a single-file flash image and a flasher that works on all three platforms
    An ESP32 build is four pieces at four offsets, and getting one offset wrong
    produces a board that boots into nothing and says nothing about why. tools/
    flash.py folds them into one image written at 0x0, so a release has one number
    to get right and it is zero.
    The same two commands now work on macOS, Linux and Windows:
    pip install esptool
    python3 tools/flash.py --image can-logger-esp32-1.0.0-esp32-4mb.bin
    It finds the board itself, falls back to the PlatformIO copy of esptool when
    the package is not installed, and says what to try when the chip never enters
    download mode.
    Also: the preview tool claimed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
    [flash.py, preview_dashboard.py]
2026-08-27 Stop the badge implying hardware verification, and say so at the top instead
    The build badge read "verified on hardware toolchain", meaning it compiles with
    the real Espressif toolchain. Nobody reads it that way - it reads as "verified
    on hardware", which is the one thing this firmware has not been. It now says
    "esp32dev compiles", which is what the check actually proves.
    A repo whose section 8 is titled "Why it does not lose frames" owes the reader
    that caveat before they scroll, not in section 13, so the note is at the top
    next to the release badge.
    CI also byte-compiles the host tools and runs the frame-map checker over the
    examples. A dashboard gets built at a desk with those tools bef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
2026-08-27 Pin the receive configuration in a test, and stop underselling it in the README
    The receive path here is not unproven. It is the same code, constant for
    constant, as a firmware that recorded hours of a 250 kbit/s bus at ~540
    frames/s with zero frames lost, across several sessions on real hardware -
    same reader task, same driver, same priorities, same FRAME_QUEUE_LEN, same SPI
    clocks, same RXB0CTRL/RXB1CTRL bits. The README described all of it as reasoned
    from datasheets, which is wrong about the part that matters most and would make
    somebody re-derive a decision that has already been settled by measurement.
    It also explains the one failure this repository has seen. Ten recordings made
    befor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
    [test_mcp2515.cpp]
2026-08-27 Name the release image for what it is, and say it is not per-OS
    The asset was called can-logger-esp32-1.0.0-esp32-4mb.bin: "esp32" twice, no
    "v" to match the tag, and nothing saying the file is the whole flash rather
    than the 0x10000 application. Renamed to
    can-logger-esp32-v1.0.0-4mb-merged.bin, where "merged" is esptool's own word
    for it, so the one thing that ruins a flash - writing an application image at
    offset 0 or a merged image at 0x10000 - is answered by the filename.
    The flashing section also read as if the three named platforms were three
    builds. They are not: the image is ESP32 machine code, the host only copies it
    over USB, and one file serves all three. Said so explicitly, bec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
2026-08-27 Add known issues and future development, and stop claiming the log has TEC/REC
    Section 14 lists the four things known to be wrong, all of them either visible
    in src/ or found in the field recordings: SG_MUL_VAL_ decodes silently wrong
    because an extended-multiplexed signal is treated as ordinary and emitted on
    every page of its frame; the MCP2515 error counters are read by nothing; the
    trigger that stalls the receive task past ~1.2 ms was never identified, only
    made survivable; and an overflow costs roughly ten frames at 540 f/s while the
    reported figure is a floor.
    Section 15 is what could be done about it, dual CAN first. Worth stating the
    shape of that one now rather than later: the driv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
2026-08-27 Remove "this logger stands in for"
    A .dbc names the node that transmits each message, and the setup sheet let you
    say which of them the logger was. Both Fill buttons then split the frame map
    between readings to watch and values to write.
    It bought one press of one button a little less sorting, and cost an
    explanation every single time anyone met it. The name in the example files was
    Host, which reads as a role the logger has rather than a string that happened
    to be in those two files, so the first question it provokes is the wrong one -
    and the honest answer for anyone recording a working machine was always "leave
    it alone, none of these nodes is you". A control that has to be explained
    bef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
    [capture_gifs.py, check_dbc.py, config.h, customise.py, dash.cpp, dash.h, test_dash.cpp, webpage.cpp]
2026-08-27 Load a frame map from the page, and ask which node the logger is - first
    Two things a .dbc cannot do for itself, and one spelling.
    FRAME MAP, in the header. Takes a .dbc off the phone or laptop in your hand and
    writes it to the card as /frames.dbc, rebuilds the map on the spot and re-binds
    the dashboard to it, saying how many saved cells no longer match. No card
    reader, no cable, no reboot.
    Streamed to the card a chunk at a time rather than buffered through a String: a
    real machine's .dbc is ninety kilobytes, which is larger than the frame map
    built from it and about a third of this chip's free heap. It lands on
    /frames.tmp and is renamed over /frames.dbc only once the whole file has
    arriv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
    [capture_gifs.py, capture_screenshots.py, config.h, customize.py, dash.cpp, dash.h, preview_dashboard.py]
2026-08-28 Fix Remove deleting the wrong sendable values, and clear the setup on a new map
    FIVE bugs, and the first one destroyed work silently.
    1. renderTxEdit() declared `var mates` twice in one function scope. The first is
    the values REMOVED together - a multiplexed set, including this card. The
    second, two hundred lines later, is the values SENT together in one frame,
    which deliberately EXCLUDES this card. `var` is function-scoped, so the
    second declaration reached back and overwrote the first for the Remove
    button, which had already closed over it. The label was built before the
    overwrite, so it kept reading "Remove all 4" while doing something else.
    Pressing Remove on a pla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
    [capture_gifs.py, capture_screenshots.py, config.h, customize.py, dash.cpp, dash.h, preview_dashboard.py, test_dash.cpp]
2026-08-28 Box a message's sendable values together in the editor, like the Send tab
    Four cards in a row with four Remove buttons invites you to treat them as four
    independent things. On the wire they are one frame, and the Send tab has always
    drawn them that way. The editor now does too: one box per message, the message
    name and what the grouping means in its header, and a Remove all N on it.
    Inside the box the rule follows what the frame actually allows.
    - Multiplexed payloads get NO individual Remove. The group's button is the
    only one, because keeping some payloads of a multiplexed command describes
    only part of it.
    - A plain message whose signals go out together keeps a Remove on eac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
2026-08-28 Keep one setup per frame map, so the desk tool cannot open on the last one
    The stale dashboard came back, from a direction the previous fix did not
    cover. Loading a map on the logger cleared what it could not account for;
    customize.py then re-seeded the mess from disk on the next run.
    Three faults, all of them in the desk path:
    * customize.py wrote every no-argument session into ONE shared setup file. Run it
    again with no frame map and yesterday's setup for another bus came back
    against no map at all: eighteen cells reading "unknown" and a role naming a
    node that was nowhere in the file. The .cfg is now named after the .dbc,
    always - with no map the page starts empty, and loading o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
    [customize.py, dash.cpp, preview_dashboard.py, test_dash.cpp, webpage.cpp, webui.cpp]
2026-08-28 Send a multiplexed frame whole: one selector code is one frame
    The setup sheet and the Send tab disagreed about what a frame is. The sheet
    drew a multiplexed message as one indivisible box - no Remove but the group's
    - while the Send tab handed every payload of it a Send button of its own. The
    Send tab was the wrong one. Two payloads under the same selector code are one
    frame, and sending one alone writes ZERO over the other: a multiplexed frame
    is the one case that cannot be seeded from what the bus last carried, because
    those bytes belonged to another code and mean something else.
    Both tabs now ask txUnits() and nobody else, so they cannot say different
    things about the same values. The r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
    [cantx.cpp, capture_screenshots.py, check_dbc.py, preview_dashboard.py, webpage.cpp]
2026-08-28 Let the operator say a frame is multiplexed when the .dbc does not
    Overlapping signals with no M/m marker are common - a bench command frame
    whose second byte means one thing under one opcode and something else under
    another. Nothing can infer that: guessing would refuse frames that are
    legitimately one message's signals side by side. So the box header now carries
    a grouped/multiplexed picker. The frame map's answer is the default; the
    choice is stored on the values (mux= and group= in the setup file) and holds
    with no frame map loaded, which is the desk tool's normal starting state.
    Marking a group multiplexed takes the individual Remove away - it becomes a
    frame that only means anything w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
2026-08-28 Multiplexed, or not: one message is one frame, and that is the whole rule
    single, grouped and multiplexed were three names for one question, and the
    frame had the answer all along. A sendable frame is now either multiplexed or
    it is not, and it is multiplexed when the .dbc says so OR when more than one of
    its signals has been set up.
    Everything set up against one message is that message's frame, so its signals
    are added, removed and sent together under one button. Gone with the
    trichotomy: group= on the send lines (one on an older file is read and not
    written back), the "sent together with" dropdown, the grouped/multiplexed
    picker, and freeGroup(). Nothing is left to decide, because a frame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
2026-08-29 Make the frame the unit a sendable value belongs to
    A frame is one message and, when the message is multiplexed, one selector
    code. Its values are added, removed and sent together under one button.
    That is not a policy - it is what a CAN frame is. Eight bytes leave the
    logger whether or not somebody typed all of them.
    The previous release got half of this right and half wrong. It treated a
    multiplexed message as ONE thing, so ABS_Cmd's six opcodes shared a box and
    a press that fired six frames. They are six separate frames and now six
    separate boxes. And Diagnostics, whose Page 0 carries SupplyVoltage AND
    BoardTemp, is two boxes of two: one frame under Page 0 carries both fields,
    so sending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
    [cantx.cpp, capture_screenshots.py, check_dbc.py, customize.py, dash.cpp, dash.h, preview_dashboard.py, test_dash.cpp]
2026-08-29 Save by itself again: a Save button left the dashboard blank
    The values on the dashboard come from the logger, not from the browser.
    handleDash() walks g_dash - the layout the LOGGER holds - and renders the
    numbers from it, so a cell the logger has not been told about is a cell it
    sends no value for. It sits blank.
    The Save to device button added in the previous commit therefore broke
    customizing: until you found and pressed it, every cell you had just placed
    showed nothing at all. Reported from the desk tool, but the firmware has
    exactly the same shape - the preview's make_dash() reads state["cfg"], which
    the POST is what updates. Autosave had been hiding this by posting
    constantly.
    So an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
    [customize.py, preview_dashboard.py, webpage.cpp]
2026-08-29 Even dashboard rows, centred numbers, a stepper you can hit
    Three visual changes; nothing about what gets sent has moved.
    Every dashboard row is now the height of the tallest widget in the grid
    rather than of its own contents, so a row of gauges and a row of numbers no
    longer step up and down the page. grid-auto-rows:1fr rather than a figure:
    with the grid's height left to its content, every 1fr row resolves to the
    tallest row's, so nothing here has to be kept in step with the widgets.
    A cell drawing no widget is only a number, and the empty widget area above it
    was pushing that number onto the floor of the cell. It now sits in the middle,
    where a gauge's needle would be.
    A number you can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
    [webpage.cpp]
2026-09-06 Record two CAN buses at once, on one clock, into one file
    Two MCP2515 controllers share VSPI; only CS and INT are unique. CAN1 is new
    hardware on D22/D21, CAN2 keeps the single-bus logger's D5/D17 so an existing
    board needs a module added rather than rewiring.
    Both ISRs notify one reader task, which drains both controllers every pass.
    Two tasks would have contended for the SPI bus mutex on the only path with a
    hard deadline, in exchange for nothing: the work is identical either way.
    Both timestamp rings are fed from the same esp_timer, so a frame on CAN1 and
    a frame on CAN2 are comparable to the microsecond, which is the whole reason
    to log two buses on one device.
    The change the second bu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
    [config.txt]
2026-09-08 Give each bus its own Frame map button
    The frame map upload used to be one header button that read the Bus tab's
    selector: to load CAN2's map you had to first open a tab you may have had no
    other reason to open, notice a selector, and change it. Nothing on the button
    said that, so the honest report from the field was that CAN2's map could not
    be uploaded at all.
    Two buttons now, side by side in the header, each carrying its own bus. The
    target is readable at the moment of the click - which matters more here than
    for most buttons, because loading a map replaces that bus's map and drops
    every dashboard cell the new one cannot account for.
    The desk tool (customize.py / tools/preview_dashboard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
    [customize.py, preview_dashboard.py, webpage.cpp]
2026-09-08 Hold a frame map per bus at the desk, and let a bus find its own bit rate
    Two things, one of them a bug I introduced last commit.
    THE BUG. customize.py / tools/preview_dashboard.py held ONE frame map. Before
    the per-bus buttons existed, a CAN2 upload from the page therefore replaced
    CAN1's map and then reported CAN2 as unmapped - it looked like it worked. Last
    commit made the button prominent, and the tool started refusing the upload
    outright rather than lying about it, which is what surfaced as an error.
    Neither behaviour was right: a CAN2 cell could not be laid out at a desk at
    all, which is the one thing that tool exists for. It now holds a map per bus,
    like the logger: --dbc2 names CAN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
    [app.cpp, config.h, customize.py, mcp2515.cpp, mcp2515.h, preview_dashboard.py, recorder.cpp, recorder.h]
2026-09-09 A role per bus, and a header column for each
    The Role button said which BU_ node of the frame map this logger IS - the fact
    that separates a reading from a command, and what both Fill buttons split on.
    There was one of it, for two buses. It could not be read: the button said
    "Role: Tester" without saying which bus that was about, and its sheet listed
    whichever map the cell editor happened to be pointed at.
    Now one per bus, and the header carries a COLUMN per controller - that bus's
    frame map above, that bus's role below:
    CAN 1 CAN 2
    [Frame map] [Frame map]
    [Role: Host] [Role: none]
    The grid is what carries the meaning, so neither button has to r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
2026-09-16 Keep the dashboard alive in station mode, and stop a Send costing frames
    Run on a real machine - station mode through a router, a WROOM board with no
    PSRAM, a large vendor frame map - this firmware lost its dashboard 25 seconds
    after boot (`write(): fail on fd 50, errno: 11`, once a second) while the
    recording carried on. The fixes below were found and measured on that bench.
    Web server
    - The page went out in parts of up to 73 KB per socket write; in station mode
    lwIP's buffer filled and the page died half-sent. Now 2 KB slices with a
    real Content-Length, served pre-compressed (src/webpage_gz.h, generated by
    tools/gen_page_gz.py, checked by run_tests.sh).
    - A client that stopped readi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
    [app.cpp, bundle.cpp]
2026-09-16 Keep draining the frame queue while a recording is being opened
    Finding a free file index is three directory searches per used slot. On a
    card with a few dozen files the start took 1.5 s, the queue filled, and the
    frames after it were dropped. Frames that arrive before the file is ready
    are now counted for the dashboard and discarded instead.
2026-09-16 Shorten frame map names for a smaller name_max instead of cutting them
    [dbc_abbrev.py]
2026-09-17 Build the setup bundle at a desk, with names and layout shortened together
    [make_bundle.py]
2026-09-17 Give the web server back 12 KB: smaller frame queue, log queue and writer stack
    Measured on a bench board with one small frame map, the largest free block
    at start-up went from 34804 to 47092 bytes, and the page went from dying
    within a minute to answering every request. Adds tools/heap_model.py, which
    predicts that block from the frame maps before anything is flashed.
2026-09-17 One desk tool: Preview as the logger will load it, a memory verdict with fixes, and a one-file export
    customize.py takes one or two frame maps or a bundle. The page's Web UI
    sheet predicts whether the logger will keep serving it and offers to trim a
    map (never a message the layout uses) or shorten names. Preview shows the
    maps as the exported bundle carries them, at that name length. Export and
    Import move logger.bundle.
    [customize.py, preview_dashboard.py, webpage.cpp]
2026-09-17 Document the desk workflow and the setup bundle; stop removing files that are not there
    SD.remove() on a missing file made the core print an error on every bundle
    upload and every restart; the removes now check first.
    [bundle.cpp, recorder.cpp, sdutil.h, webui.cpp]
2026-09-17 Replace a withdrawn measurement with the one actually made
    The 32-frame figure came from runs in which nothing was transmitted after
    start-up, so it could not have measured the transmit wait.
    [app.cpp]
2026-09-17 Trimming never drops what the dashboard or the Send tab uses
    Trim works across both maps when neither alone is enough, and every
    useful trade-off is offered: trim both at the current name length, or one
    map with shorter names. The page sends any unsaved layout change before
    trimming, previewing or exporting, so a cell or setpoint added a moment
    earlier is protected too. test/test_desk.py pins the largest messages in
    the layout and checks nothing it uses is lost.
    [make_bundle.py, preview_dashboard.py, test_desk.py, webpage.cpp]
2026-09-17 Recover from a failed SD write instead of silently recording nothing
    FatFS keeps an error on an open file once a write fails and refuses every
    later write to it. On a bench board one card error four and a half minutes
    into a recording left the CSV frozen for the remaining five minutes while
    the log beside it carried on and the status line said lost 0. The CSV is
    now reopened for appending and the write retried; bytes that still cannot
    be written are counted, shown on the status line, the page and the end of
    the recording. SD_FAULT_TEST_AT_KB injects the failure for bench tests.
    [bundle.cpp, config.h, preview_dashboard.py, recorder.cpp, recorder.h, webpage.cpp]
2026-09-17 Keep receiving between and after send attempts
    A send that lost arbitration on every attempt left the receive buffers
    alone between the attempts and while the failure was logged. On a bench
    bus at 350 frames/s, 220 such sends cost 69 received frames in ten
    minutes. The buffers are now emptied after each lost attempt, before
    sendFrame() returns, and after the send is logged.
    [cantx.cpp, mcp2515.cpp, mcp2515.h, test_mcp2515.cpp]
2026-09-17 Resume a failed SD write from the file's real length
    A write can fail after its first sector has reached the card. The
    recovery rewrote the whole block, and 29 bytes appeared twice in a bench
    recording, breaking a row. It now continues from the length the card
    reports, and counts bytes the card dropped before the block as lost. The
    fault injection lets part of the block land first, as on the bench.
    The status line now puts lost right after the time: at the end, the
    line limit printed lost 69 as lost 6.
    [recorder.cpp, sdutil.h, test_sdutil.cpp]
2026-09-17 Close what the bench bug list still had open
    The health line had outgrown the log line and was cut at minHeap, so
    block, lowBlock and allocFail never reached a recording. It is now three
    lines, and carries the drain gap and send time that were measured but
    never printed. The closing summary gives the smallest block in bytes
    against what a connection needs.
    /api/log could build the whole 80-line ring, about 14 KB, and copy it
    into a second String; on the bench board that realloc was refused. It
    now sends 16 lines a reply from one buffer taken once.
    The duplicate-field check sees underscored names.
    [config.h, logger.cpp, logger.h, recorder.cpp, test_logger.cpp, webui.cpp]
2026-09-17 Retry a Send that lost arbitration on a later pass
    The attempts inside sendFrame() are back to back, so on a bus whose
    traffic arrives in bursts all of them land inside the same burst. A send
    that loses them all now goes back on the queue and is tried again on a
    later pass, after the receive path has been drained.
    Measured twice at 5 sends/s into a bursty 350 frames/s bus, the second
    round catching the bus in a bad phase:
    3 attempts, no passes 9 failed 602 of 1265 failed
    6 attempts, no passes 1 failed 1 failed
    3 attempts, 3 passes 0 failed 0 failed
    No frames were lost in any of the six runs. More attempts back to back
    was not taken: against a nod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
    [cantx.cpp, config.h, dbc_abbrev.py, test_cantx.cpp]
2026-09-17 Send the frame a retry already built, and report it once
    Review of v2.0.2 found two faults in the retry it introduced.
    A retried send rebuilt its frame. Values that share one frame are
    assembled in a holding buffer that is consumed when the frame goes out,
    so the rebuild found them gone and transmitted the selector with a
    zeroed payload - a valid-looking command carrying wrong numbers. A retry
    now carries the frame it built and sends those bytes.
    The outcome was recorded before the retry was decided, so the dashboard,
    which keeps the first result for a ticket, showed a failure for a send
    that went out on a later pass. Nothing is recorded until the result is
    final, which also stops one retr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
    [cantx.cpp, config.h, test_cantx.cpp]
